elegooofficial/Neptune3/README.md

# Neptune3
Opensource files for ELEGOO Neptune 3 FDM 3D printer
