elegooofficial/Neptune3/Firmware/Mainboard/ZNP_F401_Marlin/config/README.md

# Where have all the configurations gone?

## https://github.com/MarlinFirmware/Configurations/archive/release-2.0.9.3.zip
