elegooofficial/Neptune3/BOM/Neptune 3_BOM.xlsx

Neptune 3_BOM
Order | Part Code | Part Name | Specification | Unit | Qty
1 | 01.001.0011 | 2020 Aluminum profile_X-axis profile | 20*20-L347mm | pcs | 1.00
2 | 01.001.0002 | 2020 Aluminum profile_Top | 20*20-L330mm | pcs | 1.00
3 | 01.002.0004 | 2040 Aluminum profile_Right | 20*40-L430mm | pcs | 1.00
4 | 01.002.0005 | 2040 Aluminum profile_Left | 20*40-L430mm | pcs | 1.00
5 | 01.003.0007 | 4040 Aluminum profile_Y-axis | 40*40-L347mm | pcs | 1.00
6 | 01.003.0005 | 4040 Aluminum profile_Bottom & Right | 40*40-L290mm | pcs | 1.00
7 | 01.003.0006 | 4040 Aluminum profile_Bottom & Left | 40*40-L290mm | pcs | 1.00
8 | 01.003.0004 | 4040 Aluminum profile_Bottom | 40*40-L250mm | pcs | 1.00
9 | 02.001.0016 | Fixing Plate_Extruder | 2.5mm Aluminum alloy plate，AL5052 | pcs | 1.00
10 | 02.002.0023 | Fixing Plate_X-axis Motor | SPCC t=2.5mm,Black powder spraying | pcs | 1.00
11 | 02.003.0001 | Bracket_Pressure Sensor | 65Mn t=2.0mm,Heat treatment hardness：45HRC,Zinc surface-plating | pcs | 1.00
12 | 02.002.0024 | Trigger_Photoelectric Switch | SPCC t=1.2mm,Black powder spraying | pcs | 1.00
13 | 02.002.0025 | Fixing Plate_Y-axis Motor | SPCC t=2.0mm,Black powder spraying | pcs | 1.00
14 | 02.002.0026 | Driven Plate_Z-axis | SPCC t=2.5mm,Black powder spraying | pcs | 1.00
15 | 02.002.0027 | Fixing Plate_Nozzle Kit | SPCC t=2.5mm,Black powder spraying | pcs | 1.00
16 | 02.002.0028 | Bottom Slider Plate | SPCC t=3.0mm,Black powder spraying | pcs | 1.00
17 | 07.006.0005 | Thermistor_Heated Bed | D1.8_L900mm_100K_With terminals | pcs | 1.00
18 | 07.006.0006 | Thermistor_Nozzle Kit | D1.8_L1500mm_100K_With terminals | pcs | 1.00
19 | 07.007.0003 | Heating Tube | 24V，40W-L1070mm，Φ6*20 | pcs | 1.00
20 | 07.005.0001 | 5015 Turbo Fan | 24V_5015_L120mm_Turbo Fan_4500 rpm_With terminals | pcs | 1.00
21 | 07.005.0007 | 4010 Turbo Fan | 24V_4010_L1420mm_Turbo Fan_6500 rpm_With terminals | pcs | 1.00
22 | 07.005.0008 | 4010 Axial Fan | 24V_4010_L1340mm_Axial Fan_5500 rpm_With terminals | pcs | 1.00
23 | 04.001.0001 | Yellew Earth Wire | 18AWG_L170mm_4.0 U-terminal+4.8 Plug spring terminal | pcs | 1.00
24 | 04.001.0002 | Black Silicone Wire | 16AWG_L170mm_4.0 U-terminal+4.8 Plug spring terminal | pcs | 1.00
25 | 04.002.0001 | Heated Bed Wire | 2*1.5mm2_L600mm_Strip 6mm at both ends and add tin | pcs | 1.00
26 | 04.001.0003 | Red Silicone Wire | 16AWG_L90mm_4.8 Plug spring terminal(Both sides) | pcs | 1.00
27 | 04.003.0001 | Red And Black Wire_Mainboard | 16AWG_L410mm_Amass XT60 female terminal+Strip 5mm and add tin | pcs | 1.00
28 | 04.004.0001 | Red And Black Wire_Power Supply | 16AWG-L200mm_Amass XT60 male terminal+4.0 U-terminal | pcs | 1.00
29 | 04.005.0011 | Motor and Limit Switch Wire_Y-axis | Motor-L530mm_Limit switch-L630mm | pcs | 1.00
30 | 04.005.0012 | Motor Wire_Z-axis | L400mm | pcs | 1.00
31 | 04.005.0013 | Photoelectric Switch Wire | L470mm | pcs | 1.00
32 | 04.001.0004 | Red Silicone Wire_Combined Switch | 16AWG_L170mm_4.0 U-terminal+4.8 Plug spring terminal | pcs | 1.00
33 | 04.005.0014 | Motor and Limit Switch Wire_X/E-axis | E-axis motor-L960mm_X-axis motor-L1010mm_X-axis limit switch-L1160mm | pcs | 1.00
34 | 04.005.0015 | Pressure Sensor Wire | L1020mm | pcs | 1.00
35 | 04.001.0011 | DC Socket Cable_Red | 18AWG_L160mm_4.0 U-terminal+Strip 5mm and add tin | pcs | 1.00
36 | 04.001.0012 | DC Socket Cable_Black | 18AWG_L195mm_4.0 U-terminal+Strip 5mm and add tin | pcs | 1.00
37 | 04.006.0002 | Filament Detector Wire | L1030mm | pcs | 1.00
38 | 05.001.0041 | Plastic Bottom Box | Black_ABS765A Fireproof materials_Fire ratingV-0 | pcs | 1.00
39 | 05.001.0042 | Plastic Bottom Cover | Black_ABS765A Fireproof materials_Fire ratingV-0 | pcs | 1.00
40 | 05.001.0043 | Power Supply Fixing Box | Black_ABS765A Fireproof materials_Fire ratingV-0 | pcs | 1.00
41 | 05.001.0044 | Fan Cover | Grey_ABS765A Fireproof materials_Fire ratingV-0 | pcs | 1.00
42 | 05.001.0045 | Air Guide Ring | Black_ABS765A Fireproof materials_Fire ratingV-0 | pcs | 1.00
43 | 05.001.0046 | Air Deflector Ⅰ | Black_ABS765A Fireproof materials_Fire ratingV-0 | pcs | 1.00
44 | 05.001.0047 | Air Deflector Ⅱ | Black_ABS765A Fireproof materials_Fire ratingV-0 | pcs | 1.00
45 | 05.001.0048 | Fixed Seat of Heated Bed Wire | Black_ABS765A Fireproof materials_Fire ratingV-0 | pcs | 1.00
46 | 05.001.0049 | Housing of Display Screen | Grey_ABS765A Fireproof materials_Fire ratingV-0 | pcs | 1.00
47 | 05.001.0050 | Cover of Display Screen | Grey_ABS765A Fireproof materials_Fire ratingV-0 | pcs | 1.00
48 | 05.001.0051 | Display Bracket | Grey_ABS765A Fireproof materials_Fire ratingV-0 | pcs | 1.00
49 | 05.001.0013 | Fixed Seat of Limit Switch_Y-axis | Black_ABS765A Fireproof materials_Fire ratingV-0 | pcs | 1.00
50 | 05.001.0052 | Tensioner Cover Ⅱ | Grey_ABS765A Fireproof materials_Fire ratingV-0 | pcs | 1.00
51 | 05.001.0053 | Mounting Seat of Sensor Adapter Plate | Black_ABS765A Fireproof materials_Fire ratingV-0 | pcs | 1.00
52 | 05.001.0054 | Mounting Seat of Guide Wheel | Black_ABS765A Fireproof materials_Fire ratingV-0 | pcs | 1.00
53 | 05.001.0055 | Housing of Filament Detector Switch | Black_ABS765A Fireproof materials_Fire ratingV-0 | pcs | 1.00
54 | 05.001.0056 | Cover of Filament Detector Switch | Black_ABS765A Fireproof materials_Fire ratingV-0 | pcs | 1.00
55 | 05.001.0057 | Compression Plate | Black_ABS765A Fireproof materials_Fire ratingV-0 | pcs | 1.00
56 | 05.001.0058 | Code Disc | Black_ABS765A Fireproof materials_Fire ratingV-0 | pcs | 1.00
57 | 05.001.0059 | Handle | Black_ABS765A Fireproof materials_Fire ratingV-0 | pcs | 1.00
58 | 05.001.0060 | Housing of Photoelectric Switch | Black_ABS765A Fireproof materials_Fire ratingV-0 | pcs | 1.00
59 | 05.001.0061 | Cover of Photoelectric Switch | Black_ABS765A Fireproof materials_Fire ratingV-0 | pcs | 1.00
60 | 05.001.0062 | Passive Slider | Grey_ABS765A Fireproof materials_Fire ratingV-0 | pcs | 2.00
61 | 05.001.0063 | Tensioner Cover | Grey_ABS765A Fireproof materials_Fire ratingV-0 | pcs | 1.00
62 | 05.001.0064 | Hand Screw Nut_D20 | Grey_ABS765A Fireproof materials_Fire ratingV-0 | pcs | 2.00
63 | 05.001.0065 | Fixed Seat of Limit Switch_X-axis | Grey_ABS765A Fireproof materials_Fire ratingV-0 | pcs | 1.00
64 | 05.001.0014 | Filament Holder | Black_ABS765A Fireproof materials_Fire ratingV-0 | pcs | 1.00
65 | 05.001.0015 | Filament Tube | Black_ABS765A+PC Fireproof materials_Fire ratingV-0 | pcs | 1.00
66 | 05.001.0016 | 4040 Profile Cover | Black_ABS765A Fireproof materials_Fire ratingV-0 | pcs | 4.00
67 | 05.001.0017 | 2020 Profile Cover | Black_ABS765A Fireproof materials_Fire ratingV-0 | pcs | 2.00
68 | 05.001.0019 | Fixed Seat of Stepper_Z-axis | Black_ABS765A Fireproof materials_Fire ratingV-0 | pcs | 1.00
69 | 05.001.0021 | Pneumatic Fittings Circlip | φ5.7mm_Blue | pcs | 3.00
70 | 05.001.0020 | Silicone Cover | Silica Gel_Black | pcs | 1.00
71 | 08.001.0013 | Mainboard_F401 | ZNP Robin Nano_DW V2.0 | pcs | 1.00
72 | 08.002.0004 | Display Screen | 4.3 inch serial port screen_DWIN | pcs | 1.00
73 | 04.011.0007 | Telephone Handset Cable | Black spring wire_RJ11 crystal head_4P4C telephone wire_2m | pcs | 1.00
74 | 04.011.0008 | Crystal Head Socket | RJ11_4P4C crystal head socket | pcs | 1.00
75 | 07.003.0001 | Limit Switch | With PCBA | pcs | 2.00
76 | 07.003.0013 | Photoelectric Switch Ⅰ | With PCBA | pcs | 1.00
77 | 08.001.0014 | Control Board of Pressure Sensor | Glevel V1.0 | pcs | 1.00
78 | 07.003.0014 | Pressure Sensor | L510mm_XH2.54-4Y | pcs | 1.00
79 | 07.003.0015 | DC Socket | DC022BC，φ2.5mm | pcs | 1.00
80 | 07.003.0016 | Photoelectric Switch Ⅱ | With PCBA | pcs | 1.00
81 | 07.002.0004 | 42-34 Stepper_Black（Flat shaft） | 42HD2037-02，Two-phase，Black | pcs | 2.00
82 | 07.002.0005 | 42-34 Stepper_Black（Circular Axis） | 42HD2037-04，Two-phase，Black | pcs | 1.00
83 | 07.002.0006 | 42-40 Stepper_Black | 42HD4027-02，Two-phase，Black | pcs | 1.00
84 | 07.001.0001 | Power Supply_Black | 24V_15A | pcs | 1.00
85 | 07.003.0003 | Combination Switch | Three-in-one combination switch | pcs | 1.00
86 | 08.003.0001 | Fuse | 10A_250V_5mm*20mm | pcs | 1.00
87 | 07.004.0002 | Heated Bed Platform | 24V_250W_235mm*235mm | pcs | 1.00
88 | 03.002.0001 | Heating Block | 20mm*20mm*10mm | pcs | 1.00
89 | 03.003.0004 | Heat Dissipation Block | AL6061_12mm*33.8mm | pcs | 1.00
90 | 03.004.0001 | Nozzle | 0.4mm | pcs | 3.00
91 | 03.005.0003 | Throat Tube_Titanium Alloy | Titanium Alloy_D7mm_M6_L27mm_through | pcs | 1.00
92 | 03.007.0001 | V-slot Wheel | Black_Imported POM_Size：24*10mm | pcs | 13.00
93 | 03.006.0001 | Metal Eccentric Spacer | D7.2mm_d5mm_H8.35mm_Outer Hexagon | pcs | 5.00
94 | 03.006.0002 | Metal Spacer | D7.2mm_d5mm_H8.35mm_Outer Hexagon | pcs | 11.00
95 | 03.007.0004 | Extruder Base | AL6061_Red anodizing | pcs | 1.00
96 | 03.007.0005 | Extruder Handle | AL6061_Red anodizing | pcs | 1.00
97 | 03.007.0003 | T-shaped Shaft Sleeve | AL6061_Red anodizing | pcs | 1.00
98 | 03.001.0002 | Extrusion Gear Ⅰ | SUS303_13.8mm*9.3mm | pcs | 1.00
99 | 03.001.0003 | Extrusion Gear Ⅱ | SUS303_13.8mm*9.3mm | pcs | 1.00
100 | 03.007.0021 | Fixed Base of Pneumatic Fittings | AL6061_Red anodizing | pcs | 1.00
101 | 06.004.0007 | Compression Spring | φ8mm*φ0.9mm*10mm | pcs | 1.00
102 | 06.004.0008 | Yellow Die Spring | D10*L18mm_Yellow | pcs | 1.00
103 | 06.001.0004 | Needle Bearing | φ3mm*φ5mm*7mm | pcs | 2.00
104 | 06.001.0002 | Ball bearing_F-624-ZZ | F-624-ZZ | pcs | 4.00
105 | 06.001.0003 | Ball bearing_625-ZZ | 625-ZZ | pcs | 26.00
106 | 06.001.0001 | Ball bearing_U-624 | U-624 | pcs | 2.00
107 | 06.001.0007 | Ball bearing_V-624 | V-624 | pcs | 2.00
108 | 06.001.0008 | Ball bearing_MR-84-ZZ | MR-84-ZZ | pcs | 1.00
109 | 06.002.0003 | Cylindrical Pin Ⅰ | D4mm_L10mm | pcs | 1.00
110 | 06.002.0004 | Cylindrical Pin Ⅱ | D4mm_L14mm | pcs | 1.00
111 | 06.003.0006 | Lead Screws_T8-8 | T8mm*8mm_L380mm | pcs | 1.00
112 | 06.003.0002 | Lead Screws Nut_T8-8 | T8mm*8mm | pcs | 1.00
113 | 06.007.0001 | Rigid Coupling | d5mm_D8mm | pcs | 1.00
114 | 06.009.0001 | Pneumatic Fittings | PC4-1/8PT | pcs | 3.00
115 | 06.006.0001 | Timing Pulley | 2GT_d5mm_20teeth-W6mm | pcs | 2.00
116 | 05.002.0001 | Timing Belt | 2GT-W6 | roll | 0.01542
117 | 06.009.0002 | Copper Sleeve_Timing Belt | D7mm_0.5mm | pcs | 4.00
118 | 05.003.0001 | Nylon Column | D7mm_d4.2mm_H15mm | pcs | 11.00
119 | 10.008.0003 | PEI Platform | 235mm*245mm | pcs | 1.00
120 | 10.008.0011 | Soft Magnetic Plate | 235mm*235mm*1mm | pcs | 1.00
121 | 10.005.0003 | Rubber Mat | 20mm*40mm*6mm | pcs | 4.00
122 | 11.008.0002 | EVA Pad | D6mm_H1mm | pcs | 0.04
123 | 09.004.0008 | Silicone Crash Pad Ⅱ | Transparent silica gel_D8mm_H2mm | pcs | 2.00
124 | 09.004.0007 | Silicone Crash Pad Ⅰ | Transparent silica gel_D8mm_H3mm | pcs | 4.00
125 | 05.007.0005 | Teflon Tube_Blue | D4mm-d2mm_Blue | m | 0.12
126 | 05.007.0001 | Teflon Tube | D4mm-d2mm_white | m | 0.34
127 | 10.001.0001 | Braided Tube | W8mm_L410mm | pcs | 2.00
128 | 10.001.0003 | Braided Tube | W12mm_L670mm | pcs | 1.00
129 | 11.003.0001 | Insulation Cotton | 50mm*60mm | pcs | 0.005
130 | 10.007.0006 | Cable Tie 2-150 | 2mm*150mm | pcs | 2.00
131 | 10.007.0004 | Cable Tie 4-150 | 4mm*150mm | pcs | 15.00
132 | 10.007.0002 | Fixed Head Cable Tie 3-100 | 3mm*100mm | pcs | 7.00
133 | 11.002.0003 | High Temperature Insulating Polyimide Tape Ⅰ | W10mm | roll | 0.0015
134 | 11.002.0002 | High Temperature Insulating Polyimide Tape Ⅱ | W50mm | roll | 0.0042
135 | 11.001.0001 | High Temp Resistant Thread Sealant | 272_Red_High Temp Resistant | g | 0.50
136 | 11.004.0001 | Grease | Transparent_Paste | g | 2.00
137 | 11.004.0002 | Thermal Grease | Grey | g | 0.20
138 | 11.006.0001 | Tin Wire | Unleaded_φ2mm_500g/roll | roll | 0.0010
139 | 11.002.0005 | Acetate Tape | Insulation_high temperature resistant_black,W40mm_30m/roll | roll | 0.0067
140 | 11.002.0004 | Adhesive Tape | W50mm_100m/roll | roll | 0.05
141 | 11.001.0002 | Instant Drying Adhesive | NO.480_Instant Drying Adhesive | g | 0.50
142 | 11.009.0001 | Heat Shrinkable Tube | φ2.5mm*20mm | pcs | 2.00
143 | 11.007.0001 | Hot Melt Glue Adhesive Stick | Transparent | pcs | 0.05
144 | 10.004.0001 | Tf Memory Card | 8G | pcs | 1.00
145 | 10.004.0002 | TF Memory Card Reader | CHUANYU | pcs | 1.00
146 | 07.001.0002 | Power Supply | Length:1.5M_Wire diameter:6.5mm_Rated power:2500W_Rated voltage:250V_Pure copper_3*0.75mm²_Plug:nickel-plated brass_Flame-Retardant PVC | pcs | 1.00
147 | 04.009.0001 | USB Cable | Bluish transparent_Type-A to Type-B_Length:53cm_Wire diameter:4.8mm | pcs | 1.00
148 | 10.008.0012 | Needle | Stainless Steel_L75mm_d0.35mm | pcs | 1.00
149 | 10.002.0001 | Metal Scraper | Stainless Steel_1.5#_Nickel-plated | pcs | 1.00
150 | 10.002.0002 | Nippers | Cutting Nippers | pcs | 1.00
151 | 10.002.0003 | 1.5mm Inner Hexagon Spanner | Carbon Steel_1.5mm_Nickel-plated | pcs | 1.00
152 | 10.002.0004 | 2.0mm Inner Hexagon Spanner | Carbon Steel_2.0mm_Nickel-plated | pcs | 1.00
153 | 10.002.0005 | 2.5mm Inner Hexagon Spanner | Carbon Steel_2.5mm_Nickel-plated | pcs | 1.00
154 | 10.002.0006 | 3.0mm Inner Hexagon Spanner | Carbon Steel_3.0mm_Nickel-plated | pcs | 1.00
155 | 10.002.0007 | 4.0mm Inner Hexagon Spanner | Carbon Steel_4.0mm_Nickel-plated | pcs | 1.00
156 | 10.002.0008 | Flat Blade Screwdriver | 2.5mm_Flat Blade | pcs | 1.00
157 | 10.002.0009 | Cruciform Screwdriver | 4.0mm_ Cruciform | pcs | 1.00
158 | 10.002.0010 | Double Open Spanner | 45#steel_8-10#_Galvanized | pcs | 1.00
159 | 10.002.0011 | Open Spanner | 45#steel_6#_Galvanized | pcs | 1.00
160 | 12.002.0001 | Self Sealing Bag Ⅰ | 18cm*26cm_Thickness:0.06mm | pcs | 1.00
161 | 12.002.0008 | Self Sealing Bag Ⅱ | 15cm*22cm_Thickness:0.08mm | pcs | 1.00
162 | 12.002.0003 | Self Sealing Bag Ⅲ | 9cm*13cm_Thickness:0.08mm | pcs | 2.00
163 | 12.002.0004 | Self Sealing Bag Ⅳ | 6cm*9cm_Thickness:0.08mm | pcs | 4.00
164 | 13.001.0001 | Filament | L5m_Random color | roll | 1.00
165 | 10.003.0001 | Product Certificate | Triangle | pcs | 1.00
166 | 12.003.0013 | Foam | 590mm*480mm*210mm | pcs | 1.00
167 | 12.001.0011 | Carton | 600mm*490mm*225mm | pcs | 1.00
168 | 10.003.0016 | User Guide | 210mm*120mm | pcs | 1.00
169 | 12.004.0012 | Manufacturing Number Sticker | 50mm*25mm | pcs | 1.00
170 | 12.004.0013 | Machine Specification Sticker | 70mm*38mm | pcs | 1.00
171 | 10.007.0003 | Plastic Twist Tie | White_Plastic Twist Tie_0.55mm*80mm | package | 0.001
172 | 10.003.0017 | Instructions | Four-color printing | pcs | 1.00
173 | 12.005.0013 | Warning Sticker | 65mm*35mm | pcs | 1.00
174 | 09.001.0002 | Hexagon Socket Countersunk Head Screw_M3*10 | Stainless Steel_M3*10 | pcs | 1.00
175 | 09.001.0001 | Hexagon Socket Countersunk Head Screw_M3*18 | Stainless Steel_M3*18 | pcs | 4.00
176 | 09.001.0009 | Hexagon Socket Countersunk Head Screw_M3*28 | Stainless Steel_M3*28 | pcs | 2.00
177 | 09.001.0003 | Hexagon Socket Countersunk Head Screw_M4*20 | Carbon Steel_M4*20 | pcs | 2.00
178 | 09.001.0010 | Cross Recessed Countersunk Head Screw_M4*22 | Stainless Steel_M4*22 | pcs | 11.00
179 | 09.002.0003 | Hexagon Socket Button Head Screw_M5*30 | Stainless Steel_M5*30 | pcs | 10.00
180 | 09.002.0001 | Hexagon Socket Button Head Screw_M3*6 | Stainless Steel_M3*6 | pcs | 14.00
181 | 09.002.0006 | Hexagon Socket Button Head Screw_M5*8 | Stainless Steel_M5*8 | pcs | 6.00
182 | 09.002.0007 | Hexagon Socket Button Head Screw_M4*16 | Stainless Steel_M4*16 | pcs | 7.00
183 | 09.002.0012 | Hexagon Socket Button Head Screw_M3*8 | Stainless Steel_M3*8 | pcs | 1.00
184 | 09.002.0011 | Hexagon Socket Button Head Screw_M4*12 | Stainless Steel_M4*12 | pcs | 1.00
185 | 09.002.0004 | Hexagon Socket Button Head Screw_M3*10 | Stainless Steel_M3*10 | pcs | 9.00
186 | 09.002.0005 | Hexagon Socket Button Head Screw_M5*40 | Stainless Steel_M5*40 | pcs | 3.00
187 | 09.002.0009 | Hexagon Socket Button Head Screw_M3*12 | Stainless Steel_M3*12 | pcs | 2.00
188 | 09.002.0002 | Hexagon Socket Button Head Screw_M3*16 | Stainless Steel_M3*16 | pcs | 2.00
189 | 09.003.0007 | Hexagon Socket Head Cap Screw_M4*10 | Stainless Steel_M4*10 | pcs | 4.00
190 | 09.003.0002 | Hexagon Socket Head Cap Screw_M3*18 | Stainless Steel_M3*18 | pcs | 4.00
191 | 09.003.0004 | Hexagon Socket Head Cap Screw_M4*20 | Stainless Steel_M4*20 | pcs | 2.00
192 | 09.003.0012 | Hexagon Socket Head Cap Screw_M3*5 | Stainless Steel_M3*5 | pcs | 3.00
193 | 09.003.0001 | Hexagon Socket Head Cap Screw_M4*8 | Stainless Steel_M4*8 | pcs | 7.00
194 | 09.003.0008 | Hexagon Socket Head Cap Screw_M3*20 | Stainless Steel_M3*20 | pcs | 1.00
195 | 09.003.0009 | Hexagon Socket Head Cap Screw_M3*25 | Stainless Steel_M3*25 | pcs | 1.00
196 | 09.004.0003 | M5 Flat Washer | Stainless Steel_M5 | pcs | 5.00
197 | 09.004.0001 | M5 Flat Washer_V-slot Wheel | Stainless Steel_M5_φ5mm*φ8mm*1mm | pcs | 13.00
198 | 09.004.0005 | M3 Flat Washer | Stainless Steel_M3_φ3.2mm*φ6.5mm*0.5mm | pcs | 1.00
199 | 09.004.0006 | M3 Silicone Flat Rubber Washer | Silicone_M3_φ3mm*φ7mm*1mm | pcs | 4.00
200 | 09.004.0002 | M3 Spring Washer | Stainless Steel_M3 | pcs | 2.00
201 | 09.005.0002 | M5 Self-locking Nut | Stainless Steel_M5 | pcs | 13.00
202 | 09.005.0001 | M4 T-nut | Stainless Steel_M4 | pcs | 7.00
203 | 09.005.0006 | M3 Blind Rivet Nuts | Carbon Steel_M3 | pcs | 1.00
204 | 09.005.0005 | M4 Square Slide Nut | 2020 Aluminum profile_M4 Square Slide Nut | pcs | 2.00
205 | 09.006.0006 | Large Flat Head Tapping Screw_Point Tail_3*25 | Stainless Steel_TA 3*25 | pcs | 2.00
206 | 09.006.0003 | Pan Head Tapping Screws_Point Tail_3*8 | Carbon Steel_PA 3*8 | pcs | 8.00
207 | 09.006.0002 | Pan Head Tapping Screws_Point Tail_3*12 | Stainless Steel_PA 3*12 | pcs | 9.00
208 | 09.006.0005 | Pan Head Tapping Screws_Scrape Tail_3*6 | Stainless Steel_PT 3*6 | pcs | 6.00
209 | 09.006.0007 | Pan Head Tapping Screws_Point Tail_3*16 | Stainless Steel_PA 3*16 | pcs | 2.00
210 | 09.006.0008 | Pan Head Tapping Screws_Point Tail_2*8 | Stainless Steel_PA 2*8 | pcs | 4.00
211 | 09.006.0009 | Pan Head Tapping Screws_Point Tail_2*10 | Stainless Steel_KA 2*10 | pcs | 2.00
212 | 09.007.0004 | Combination Screw with Spring washer_M5*45 | Carbon Steel_M5*45 | pcs | 14.00
213 | 09.007.0002 | Combination Screw with Spring washer_M4*18 | Carbon Steel_M4*18 | pcs | 4.00
214 | 09.007.0001 | Combination Screw_M3*4 | Stainless Steel_M3*4 | pcs | 1.00
215 | 09.007.0003 | Combination Screw with Spring washer_M5*25 | Carbon Steel_M5*25 | pcs | 4.00
216 | 09.008.0008 | Album screw_M4*16_Female Nail | Stainless Steel_L16mm | pcs | 2.00
217 | 09.008.0001 | Set Screw_M3*3 | Carbon Steel_M3*3 | pcs | 2.00
218 | 09.008.0009 | Album screw_M4*10_Female Nail | Stainless Steel_L10mm | pcs | 2.00
219 | 09.008.0010 | Album screw_M4_Male Nail | Stainless Steel_M3*10 | pcs | 4.00
220 | 09.008.0007 | Album screw_M4*5_Female Nail | Stainless Steel_L5mm | pcs | 2.00
