elegooofficial/Neptune3/(list of files, cad)

Other CAD files:
Wire/Red And Black Wire_Mainboard.dwg
2D/Mounting Seat of Sensor Adapter Plate-A.DWG
Wire/Thermistor_Nozzle Kit.dwg
2D/Throat Tube.DWG
Wire/5015 Turbo Fan.dwg
2D/Tensioner Cover Ⅱ-A.DWG
Wire/Thermistor_Heated Bed.dwg
2D/T-shaped Shaft Sleeve-C.DWG
Wire/4010 Axial Fan.dwg
2D/Trigger_Photoelectric Switch-A.DWG
2D/Power Supply Fixing Box-B.DWG
Wire/Motor Wire_Z-axis.dwg
2D/Plastic Bottom Box-A.DWG
Wire/Motor and Limit Switch Wire_XE-axis.dwg
2D/Nozzle.DWG
Wire/4010 Turbo Fan.dwg
2D/Silicone Cover.DWG
Wire/Yellew Earth Wire.dwg
2D/Passive Slider.DWG
Wire/Photoelectric Switch Wire.dwg
2D/Tensioner Cover.DWG
Wire/Red And Black Wire_Power Supply.dwg
2D/V-slot Wheel.DWG
Wire/Red Silicone Wire.dwg
2D/Plastic Bottom Cover-A.DWG
Wire/Pressure Sensor Wire.dwg
2D/4040 Aluminum profile_Bottom.DWG
Wire/DC Socket Cable_Red.dwg
2D/2040 Aluminum profile_Right-A.DWG
Wire/Motor and Limit Switch Wire_Y-axis.dwg
2D/Fixing Plate_Extruder-B.DWG
Wire/Red Silicone Wire_Combined Switch.dwg
2D/2020 Aluminum profile_Top.DWG
Wire/Heating Tube.dwg
2D/Metal Eccentric Spacer.DWG
Wire/Heated Bed Wire.dwg
2D/Air Deflector Ⅰ-A.DWG
Wire/Black Silicone Wire.dwg
2D/Cover of Photoelectric Switch-A.DWG
Wire/Filament Detector Wire.dwg
2D/Heat Dissipation Block-B.DWG
Wire/DC Socket Cable_Black.dwg
2D/Code Disc-A.DWG
2D/Extruder BaseA.DWG
2D/Compression Plate-A.DWG
2D/Extrusion Gear 1.DWG
2D/Air Deflector Ⅱ-A.DWG
2D/Handle-A.DWG
2D/Heating Block.DWG
2D/Housing of Filament Detector Switch-A.DWG
2D/Driven Plate_Z-axis-A.DWG
2D/Fixed Seat of Limit Switch_X-axis.DWG
2D/Fixing Plate_Y-axis Motor-B.DWG
2D/2020 Profile Cover.DWG
2D/Fixed Seat of Limit Switch_Y-axis.DWG
2D/4040 Profile Cover.DWG
2D/Fan Cover-A.DWG
2D/2020 Aluminum profile_X-axis-A.DWG
2D/Fixed Seat of Stepper_Z-axis.DWG
2D/Cover of Display Screen-A.DWG
2D/Fixed Base of Pneumatic Fittings-B.DWG
2D/2040 Aluminum profile_Left-A.DWG
2D/Fixed Seat of Heated Bed Wire-A.DWG
2D/4040 Aluminum profile_Bottom & Right-B.DWG
2D/Filament Tube.DWG
2D/Bracket_Pressure Sensor-A.DWG
2D/Fixing Plate_Nozzle Kit-A.DWG
2D/Housing of Photoelectric Switch-A.DWG
2D/Cover of Filament Detector Switch-A.DWG
2D/Fixing Plate_X-axis Motor-B.DWG
2D/Display Bracket-A.DWG
2D/Extruder Handle-A.DWG
2D/Extrusion Gear 2.DWG
2D/Bottom Slider Plate-A.DWG
2D/4040 Aluminum profile_Bottom & Left-B.DWG
2D/Air Guide Ring-A.DWG
2D/Filament Holder.DWG
2D/Mounting Seat of Guide Wheel-A.DWG
2D/Housing of Display Screen-A.DWG
2D/Hand Screw Nut_D20.DWG
2D/Lead Screws Nut_T8.DWG
2D/Lead Screws_T8-8.DWG
