elegooofficial/Neptune3/2D/Mounting Seat of Guide Wheel-A.PDF

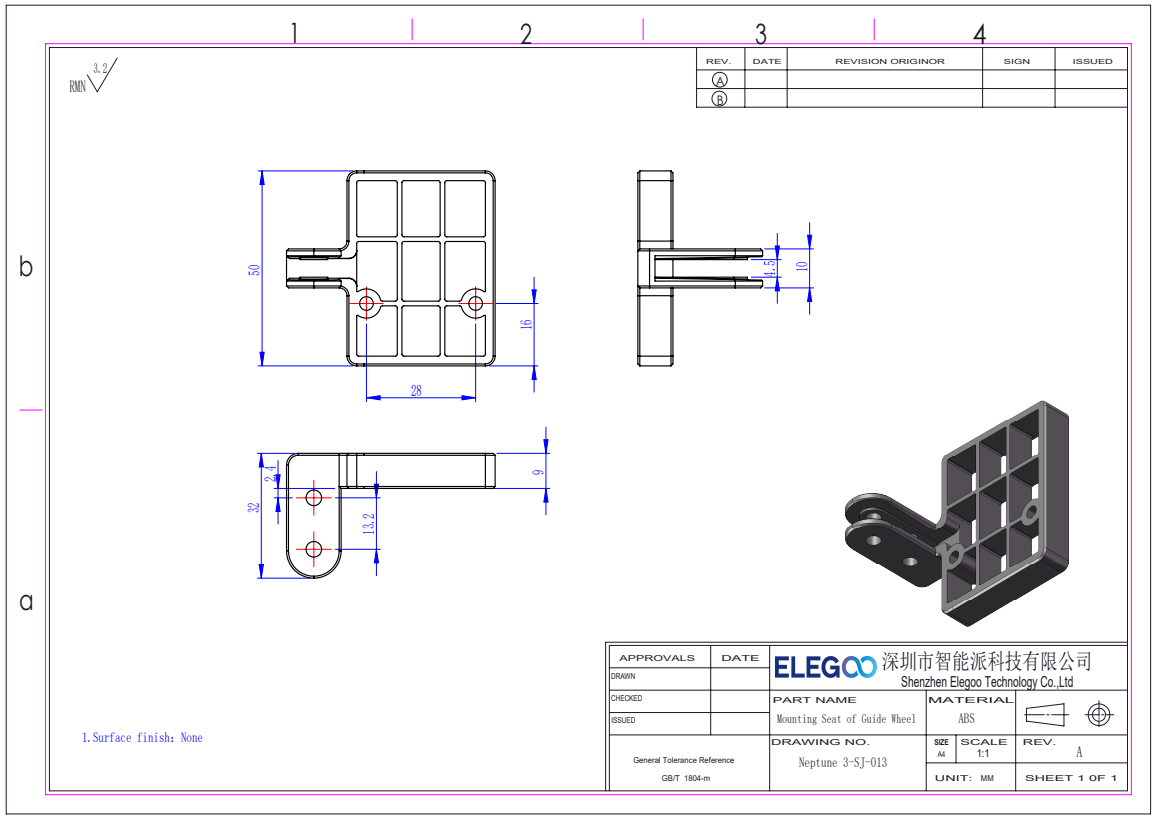
[picture p1: page 1]
Mounting Seat of Guide Wheel; ABS; Neptune 3-SJ-013; SIZE SCALE; UNIT: MM; DRAWING NO.; REV.; DATE; REVISION ORIGINOR; SIGN; ISSUED; PART NAME; SHEET 1 0F 1

深圳市智能派科技有限公司
Shenzhen Elegoo Technology Co.,Ltd

1.Surface finish：None

General Tolerance Reference
