elegooofficial/Neptune3/Wire/4010 Axial Fan.pdf

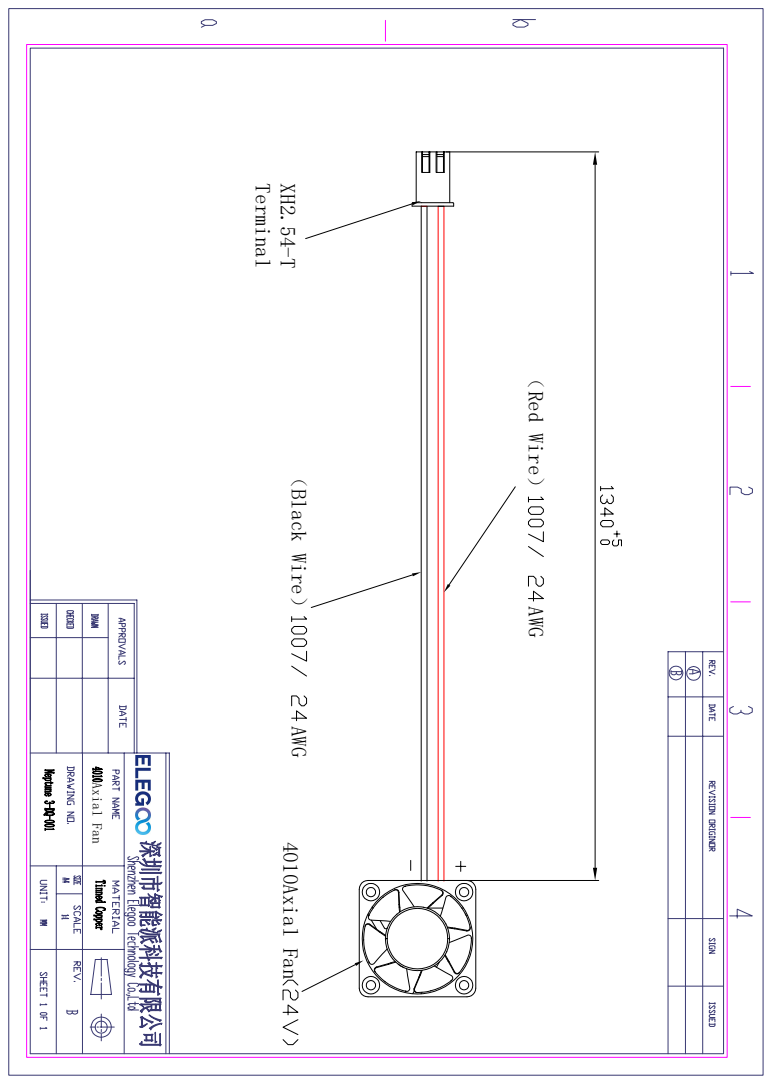
[picture p2: page 1]
Axial Fan; 4010Axial Fan; Terminal

（Red Wire） AWG

（Black Wire） AWG
