elegooofficial/Neptune3/Wire/4010 Turbo Fan.pdf

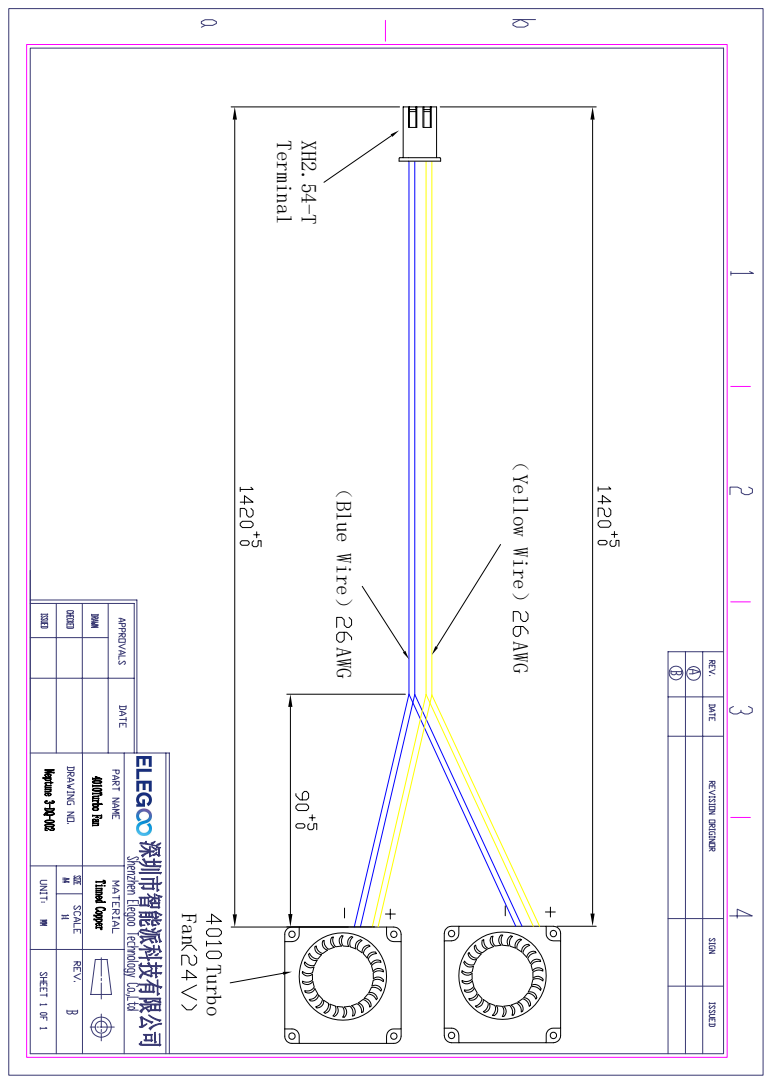
[picture p3: page 1]
Terminal; Turbo; Fan

（Yellow Wire） AWG

（Blue Wire） AWG
