elegooofficial/Neptune3/Wire/5015 Turbo Fan.pdf

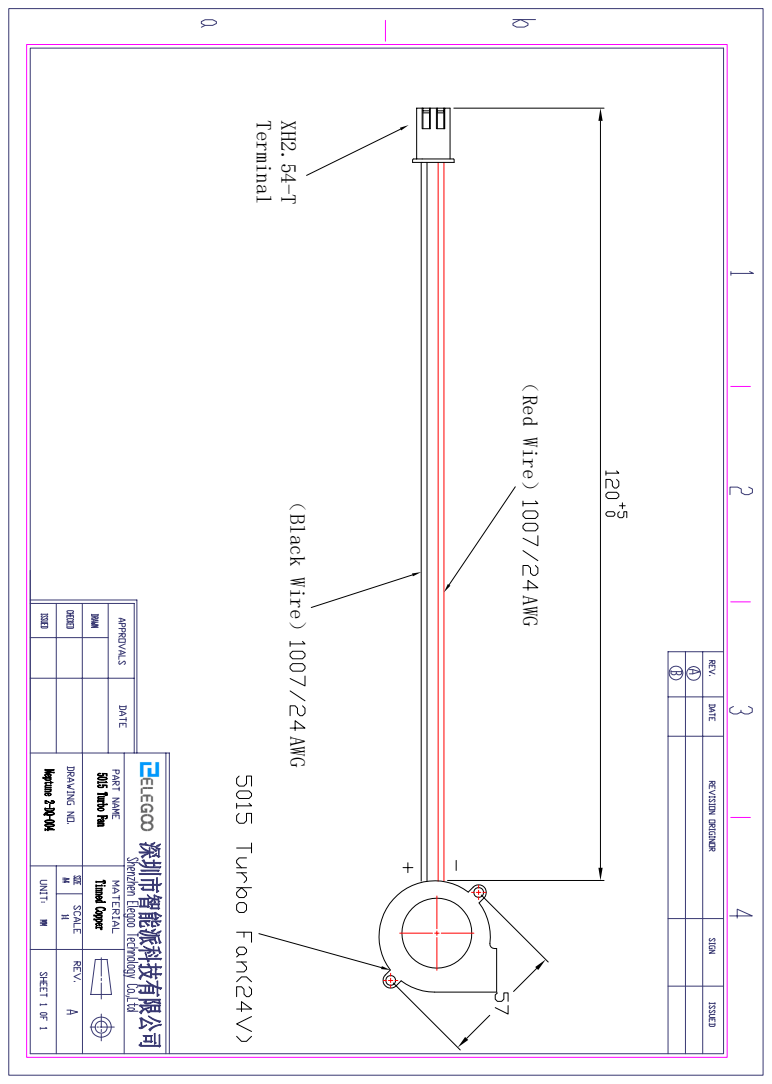
[picture p4: page 1]
Terminal

（Red Wire） AWG

（Black Wire） AWG
