elegooofficial/Neptune3/Wire/DC Socket Cable_Black.pdf

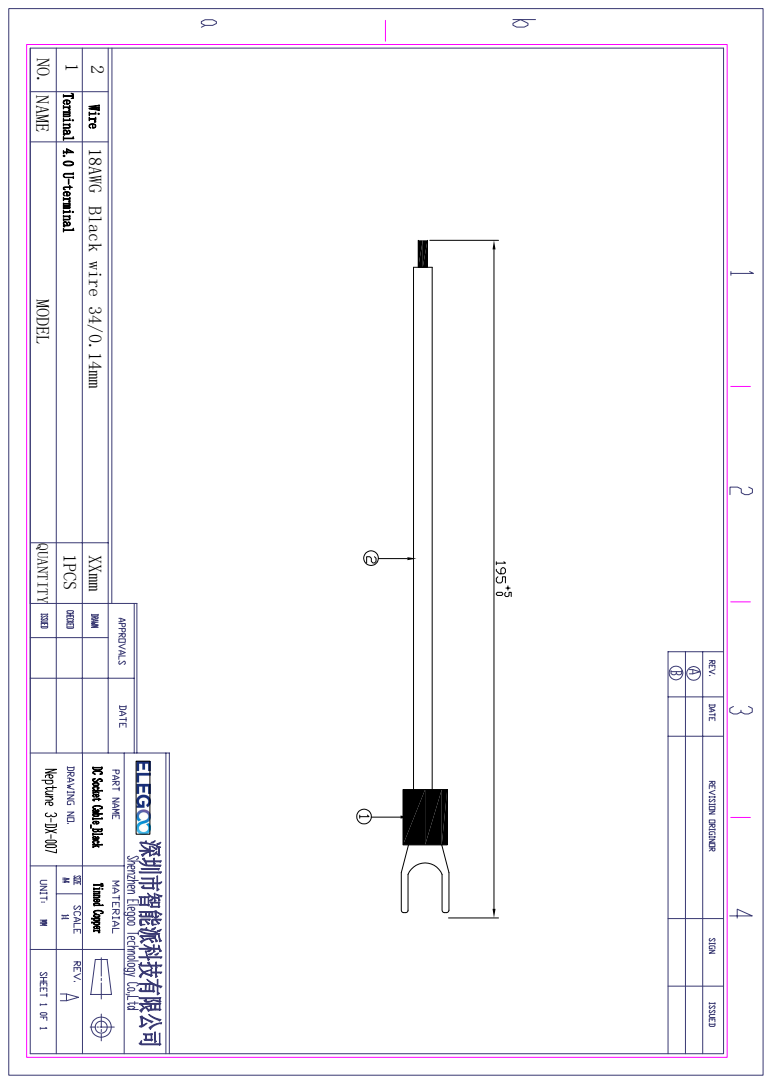
[picture p5: page 1]
1PCS

QUANTITY NO. NAME MODEL

2 18AWG Black wire 34/0.14mm XXmm
