elegooofficial/Neptune3/Wire/DC Socket Cable_Red.pdf

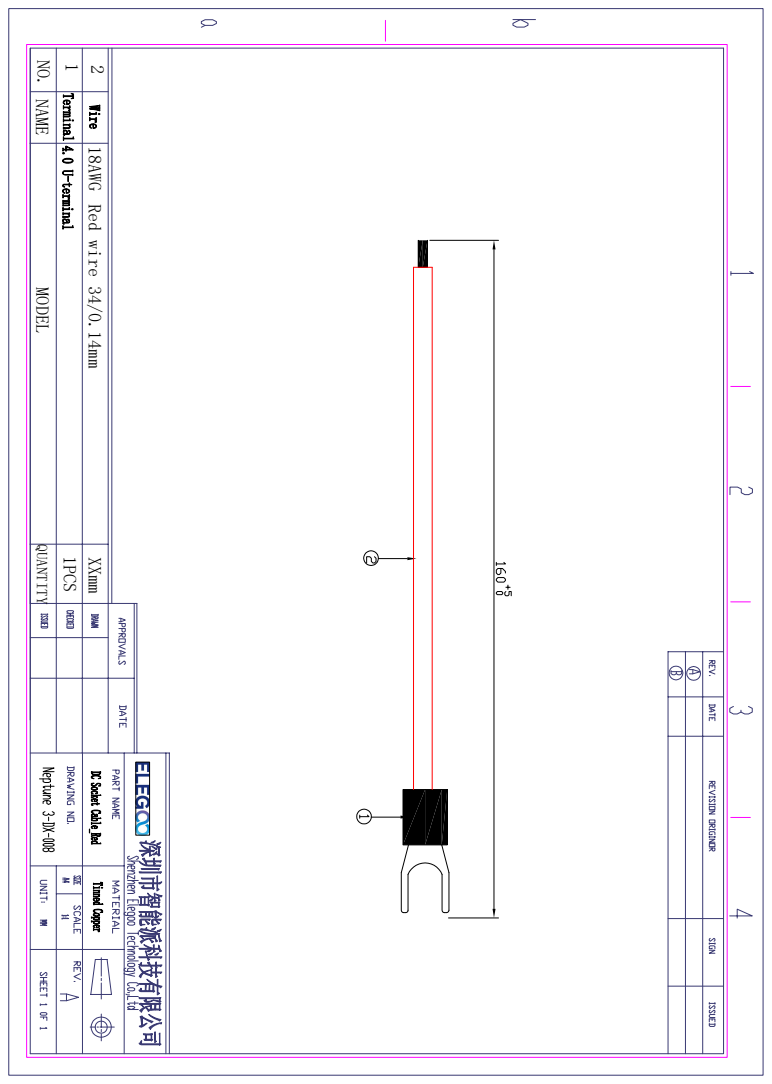
[picture p6: page 1]
1PCS

QUANTITY NO. NAME MODEL

XXmm 18AWG Red wire 34/0.14mm
