elegooofficial/Neptune3/Wire/Heated Bed Wire.pdf

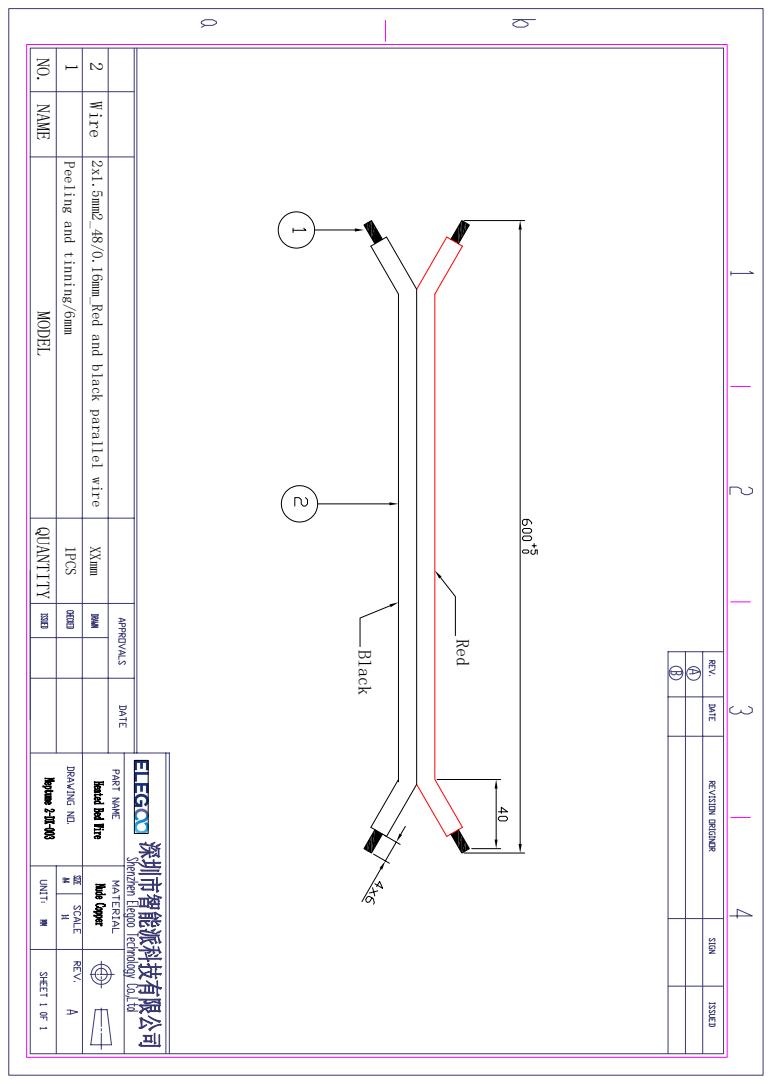
[picture p7: page 1]
NAME; Wire; MODEL; 1PCS; XXmm; QUANTITY; Red; Black

Peeling and tinning/6mm

2x1.5mm2_48/0.16mm_Red and black parallel wire
