elegooofficial/Neptune3/Wire/Heating Tube.pdf

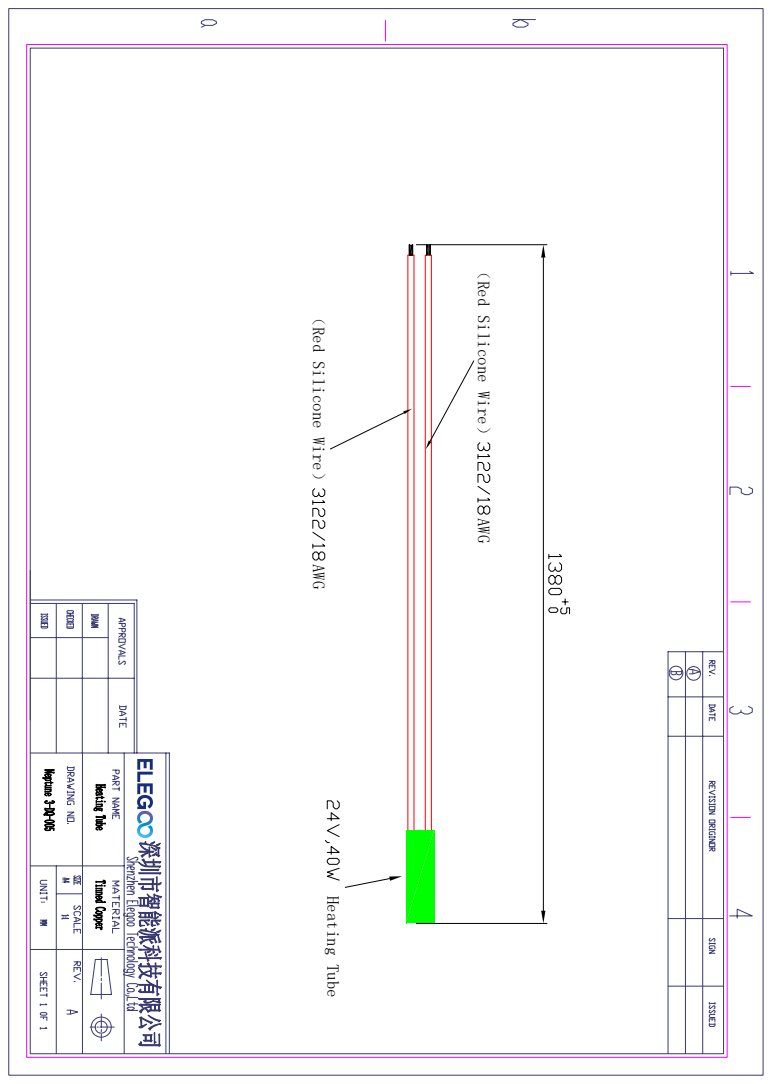
[picture p8: page 1]

（Red Silicone Wire） AWG

（Red Silicone Wire） AWG Heating Tube
