elegooofficial/Neptune3/Wire/Thermistor_Heated Bed.pdf

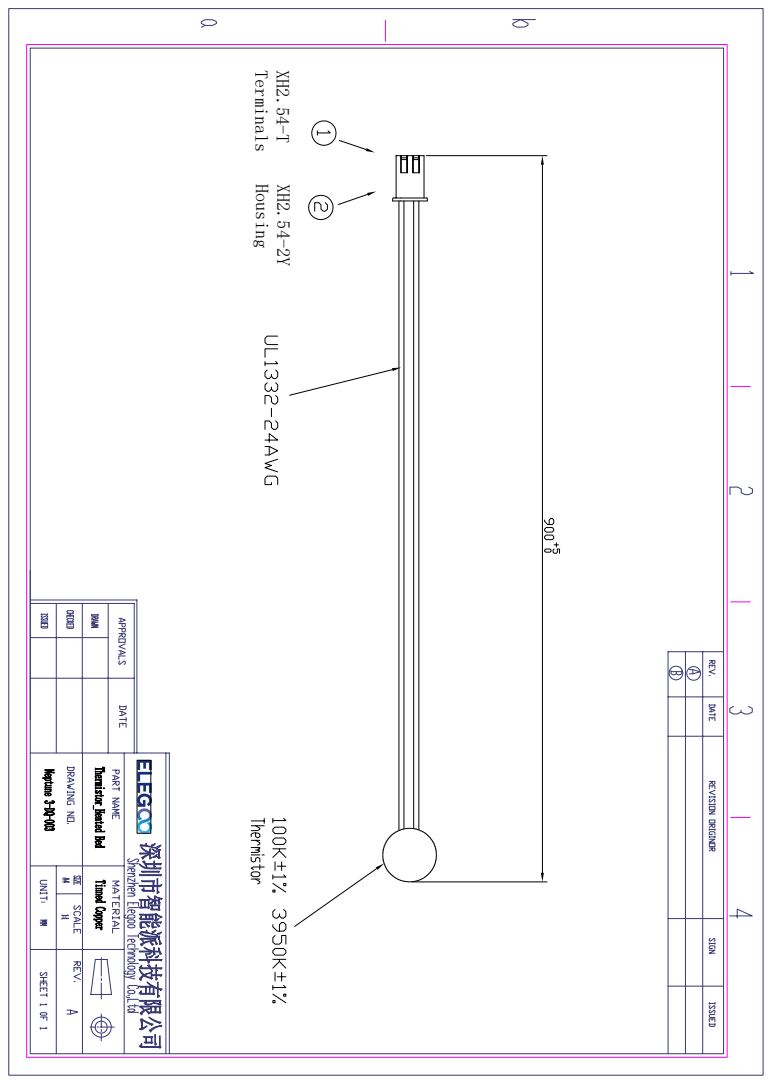
[picture p9: page 1]
Terminals; Housing
