elegooofficial/Neptune3/Wire/Thermistor_Nozzle Kit.pdf

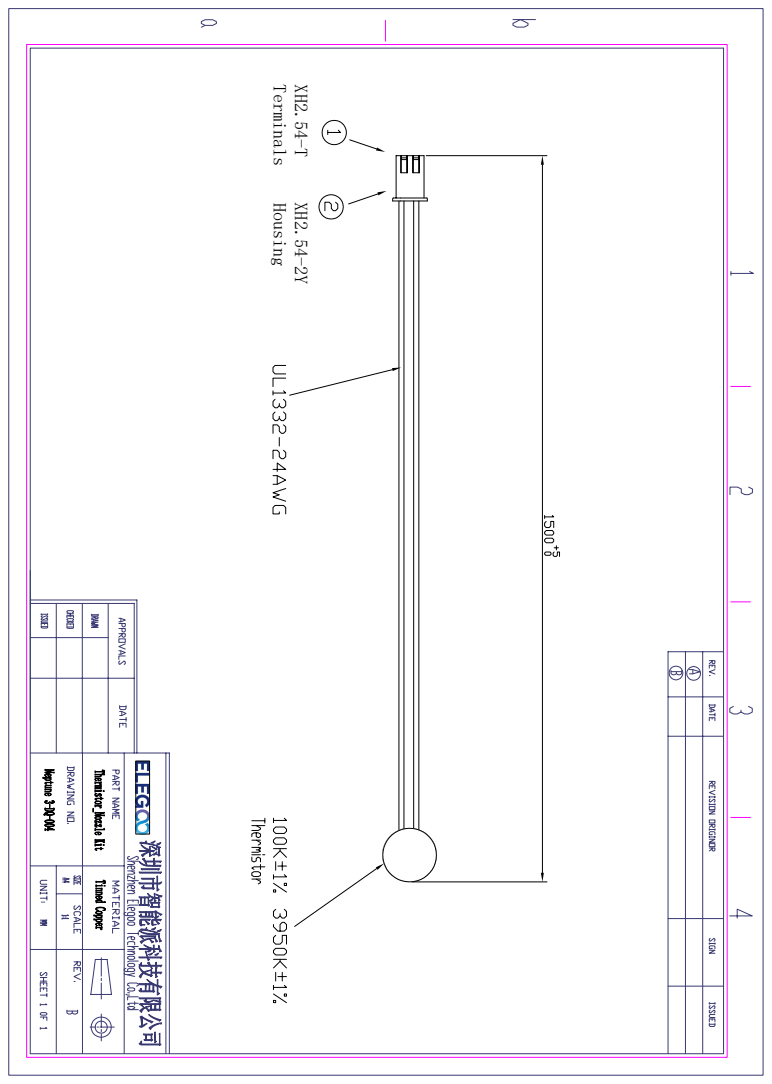
[picture p10: page 1]
Terminals; Housing
