elegooofficial/Neptune3/Wire/Yellew Earth Wire.pdf

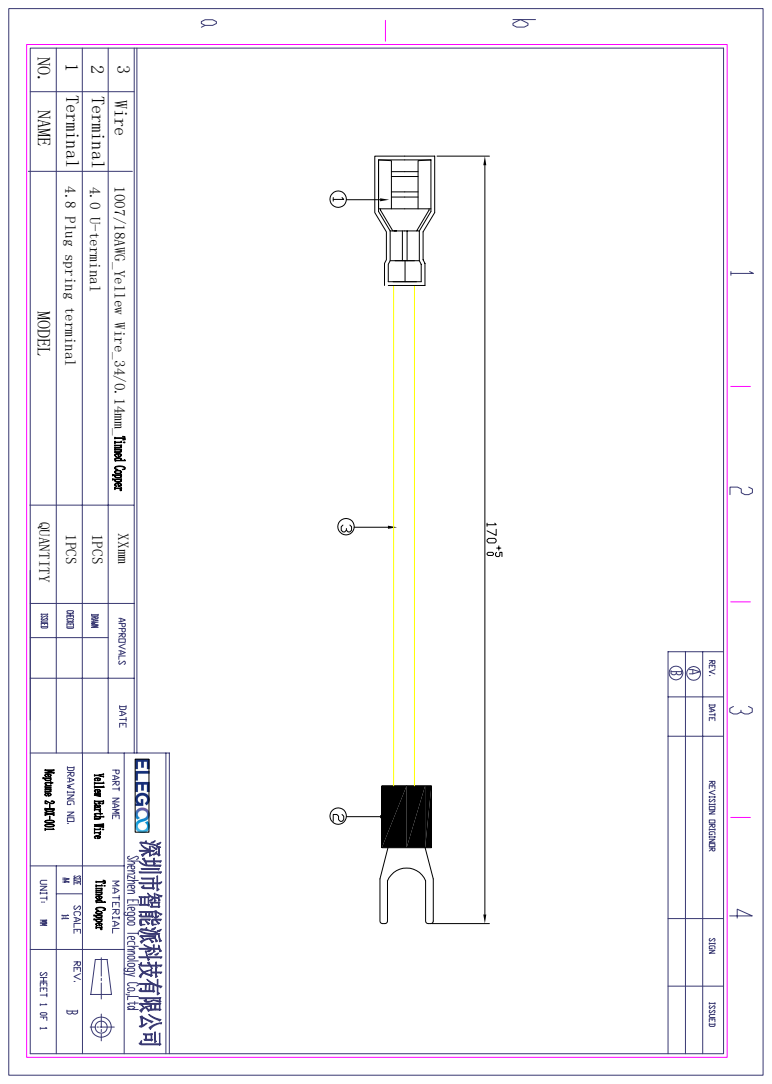
[picture p11: page 1]
Terminal; Wire; NAME; 4.0 U-terminal; 1007/18AWG_Yellew Wire_34/0.14mm_; MODEL; 1PCS; XXmm; QUANTITY

4.8 Plug spring terminal
