elegooofficial/Neptune3/2D/Mounting Seat of Sensor Adapter Plate-A.PDF

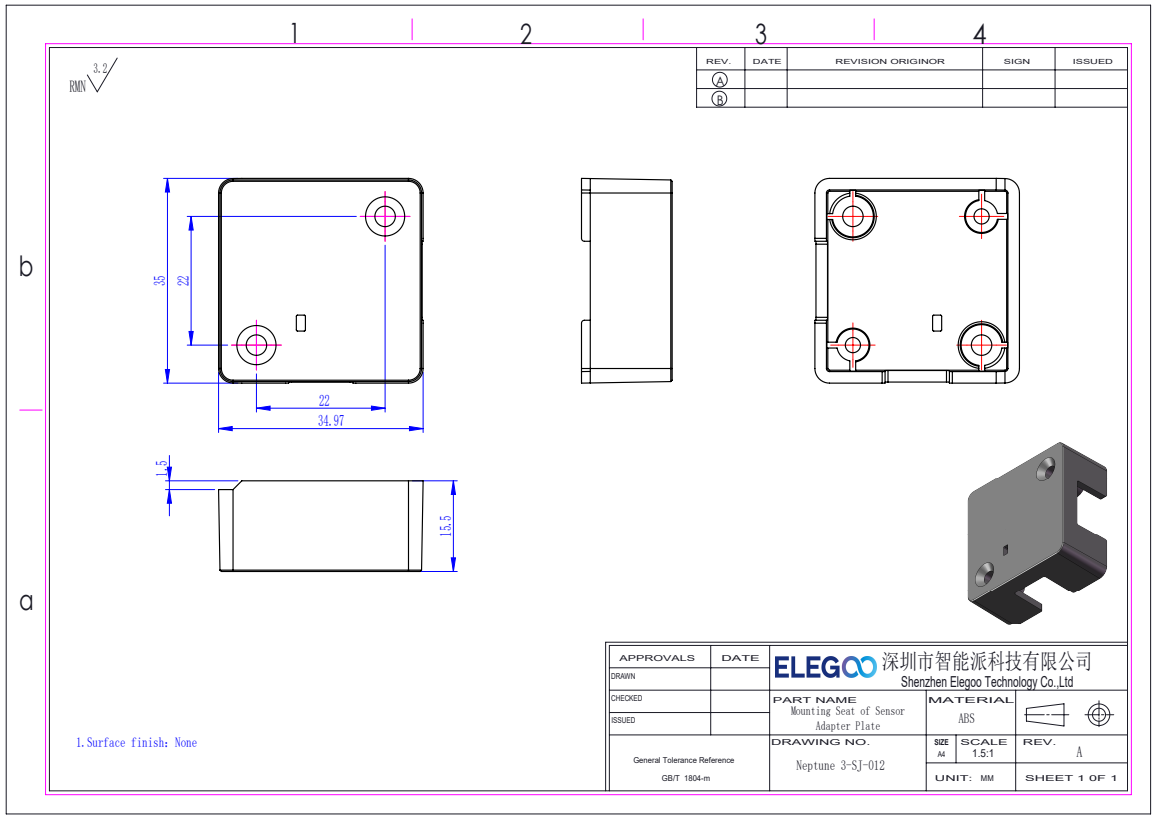
[picture p12: page 1]
Neptune 3-SJ-012; 1.Surface finish：None; SIZE SCALE; UNIT: MM; DRAWING NO.; REV.; DATE; REVISION ORIGINOR; SIGN; ISSUED; SHEET 1 0F 1

深圳市智能派科技有限公司
Shenzhen Elegoo Technology Co.,Ltd

PART NAME
Mounting Seat of Sensor
Adapter Plate

General Tolerance Reference
