elegooofficial/Neptune3/2D/Nozzle.PDF

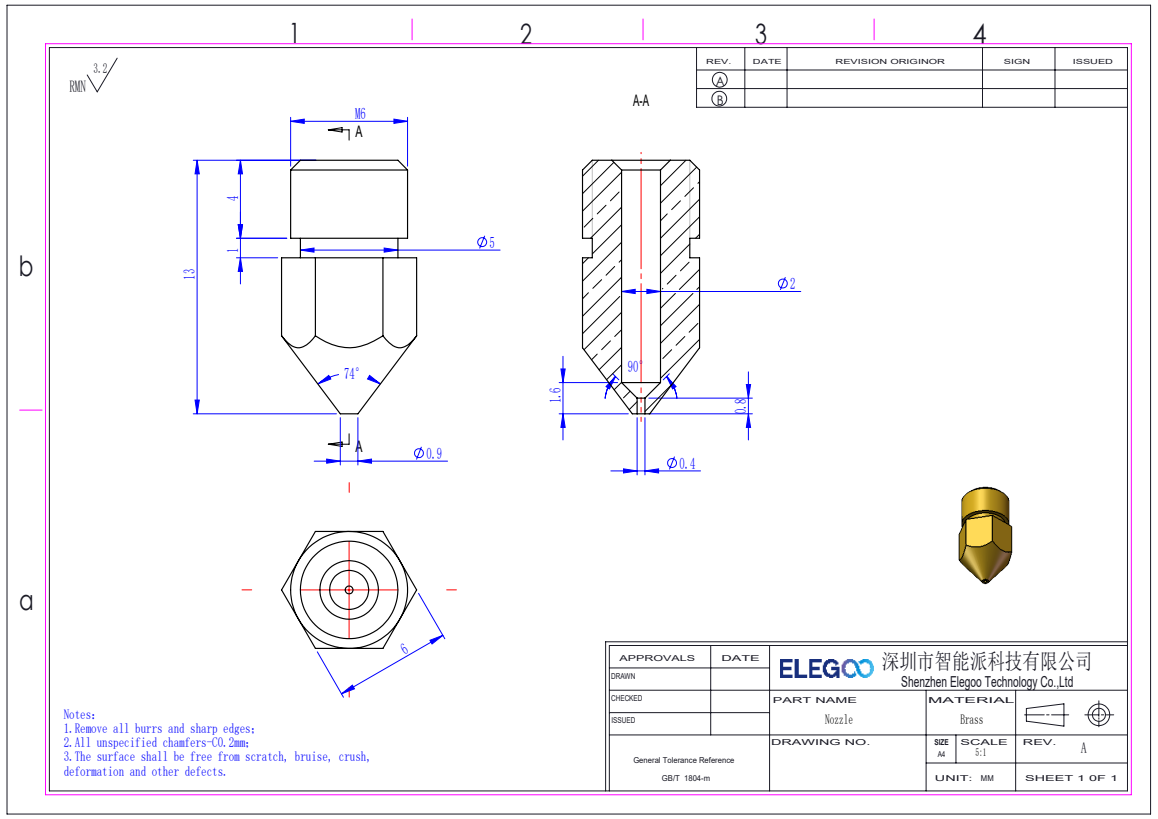
[picture p13: page 1]
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

深圳市智能派科技有限公司
Shenzhen Elegoo Technology Co.,Ltd

Notes：
1.Remove all burrs and sharp edges；
2.All unspecified chamfers-C0.2mm；
3.The surface shall be free from scratch, bruise, crush,
deformation and other defects.

General Tolerance Reference
