elegooofficial/Neptune3/2D/Passive Slider.PDF

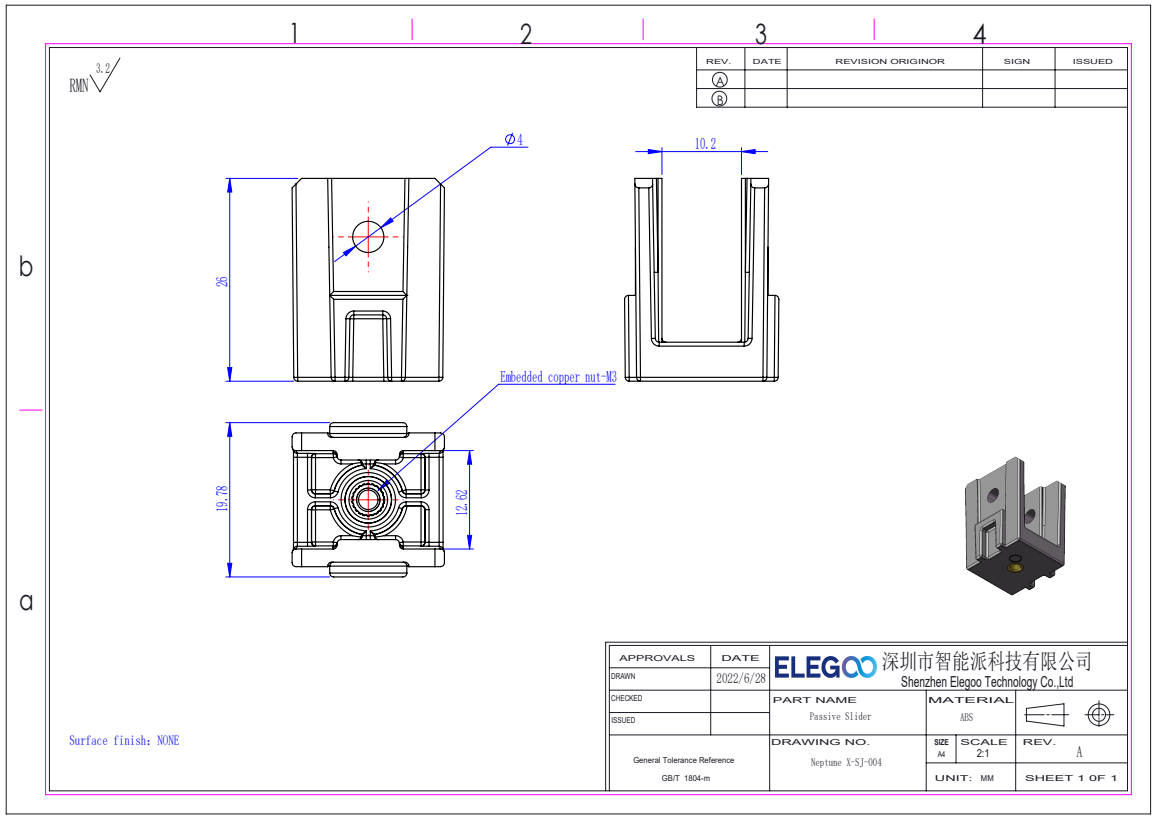
[picture p14: page 1]
Passive Slider; ABS; Neptune X-SJ-004; Surface finish：NONE; SIZE SCALE; UNIT: MM; DRAWING NO.; REV.; DATE; REVISION ORIGINOR; SIGN; ISSUED; PART NAME; SHEET 1 0F 1

Embedded copper nut-M3

深圳市智能派科技有限公司
Shenzhen Elegoo Technology Co.,Ltd

General Tolerance Reference
