elegooofficial/Neptune3/2D/Tensioner Cover.PDF

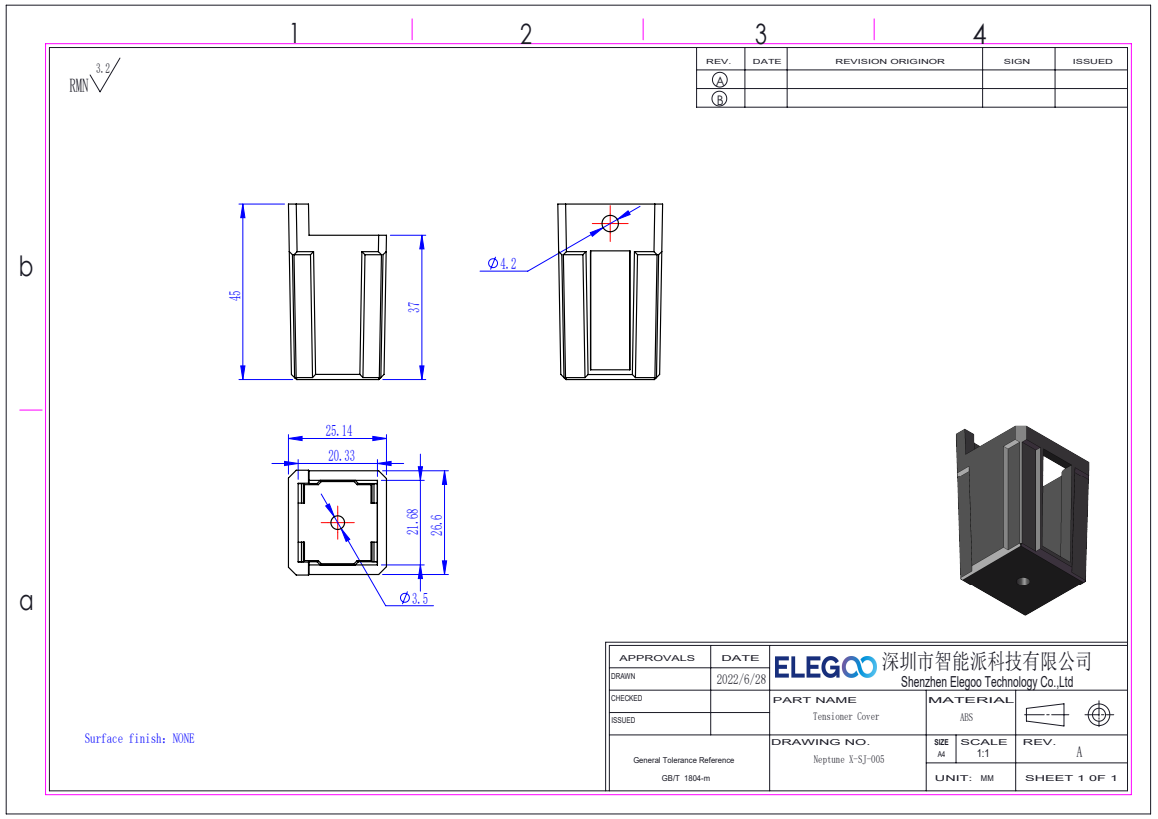
[picture p15: page 1]
Tensioner Cover; ABS; Neptune X-SJ-005; SIZE SCALE; UNIT: MM; DRAWING NO.; REV.; DATE; REVISION ORIGINOR; SIGN; ISSUED; PART NAME; SHEET 1 0F 1

深圳市智能派科技有限公司
Shenzhen Elegoo Technology Co.,Ltd

Surface finish：NONE

General Tolerance Reference
