elegooofficial/Neptune3/2D/Trigger_Photoelectric Switch-A.PDF

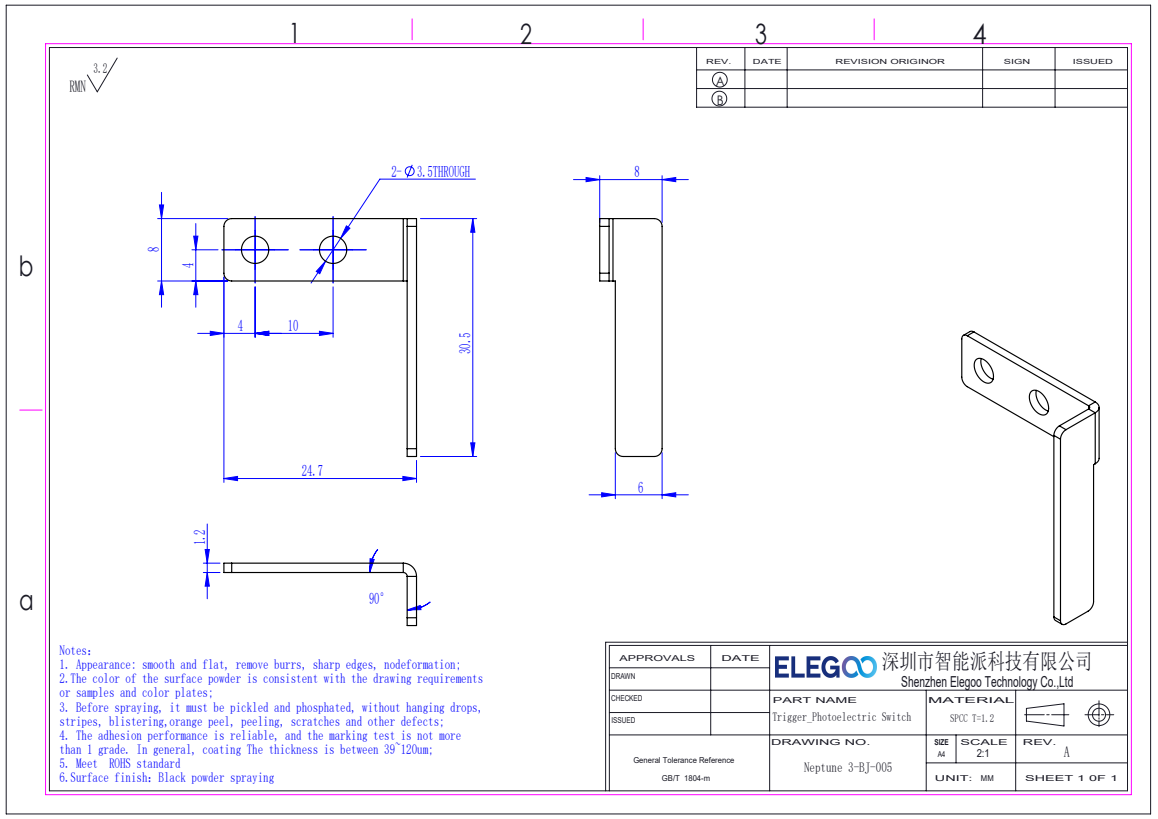
[picture p16: page 1]
2- 3.5THROUGH; Trigger_Photoelectric Switch; SPCC T=1.2; Neptune 3-BJ-005; SIZE SCALE; UNIT: MM; DRAWING NO.; REV.; DATE; REVISION ORIGINOR; SIGN; ISSUED; PART NAME; SHEET 1 0F 1

Notes：
1. Appearance: smooth and flat, remove burrs, sharp edges, nodeformation;
2.The color of the surface powder is consistent with the drawing requirements
or samples and color plates;
3. Before spraying, it must be pickled and phosphated, without hanging drops,
stripes, blistering,orange peel, peeling, scratches and other defects;
4. The adhesion performance is reliable, and the marking test is not more
than 1 grade. In general, coating The thickness is between 39~120um;
5. Meet ROHS standard
6.Surface finish：Black powder spraying

深圳市智能派科技有限公司
Shenzhen Elegoo Technology Co.,Ltd

General Tolerance Reference
