elegooofficial/Neptune3/2D/Cover of Filament Detector Switch-A.PDF

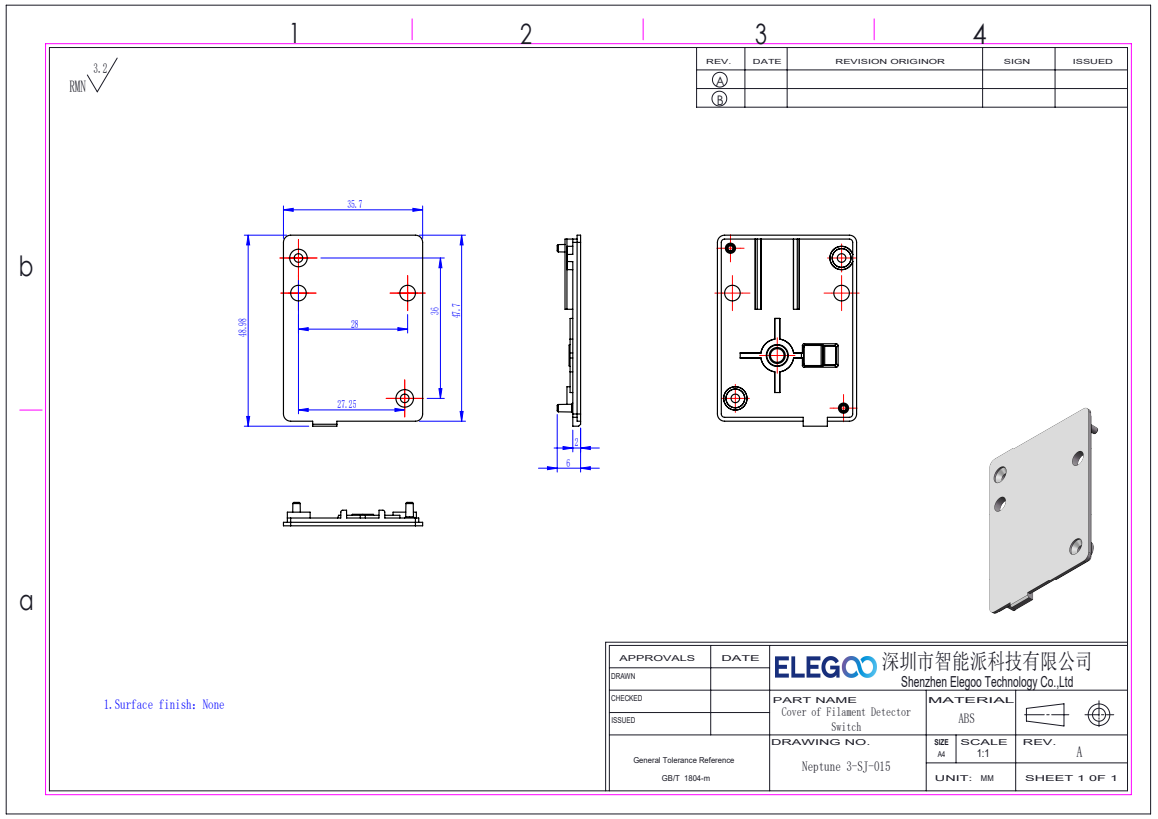
[picture p17: page 1]
Neptune 3-SJ-015; SIZE SCALE; UNIT: MM; DRAWING NO.; REV.; DATE; REVISION ORIGINOR; SIGN; ISSUED; SHEET 1 0F 1

深圳市智能派科技有限公司
Shenzhen Elegoo Technology Co.,Ltd

1.Surface finish：None

PART NAME
ABS Cover of Filament Detector

General Tolerance Reference
