elegooofficial/Neptune3/2D/Display Bracket-A.PDF

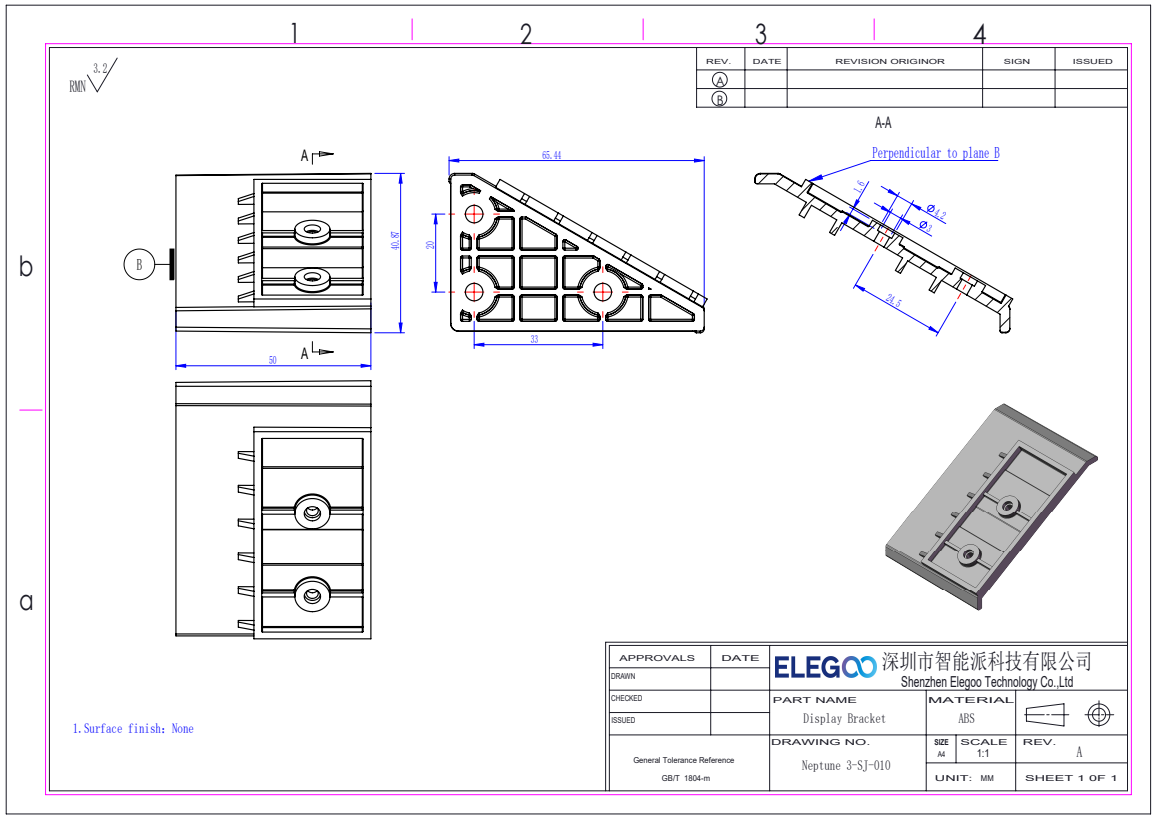
[picture p18: page 1]
Display Bracket; ABS; Neptune 3-SJ-010; SIZE SCALE; UNIT: MM; DRAWING NO.; REV.; DATE; REVISION ORIGINOR; SIGN; ISSUED; PART NAME; SHEET 1 0F 1

Perpendicular to plane B

深圳市智能派科技有限公司
Shenzhen Elegoo Technology Co.,Ltd

1.Surface finish：None

General Tolerance Reference
