elegooofficial/Neptune3/2D/Extruder BaseA.PDF

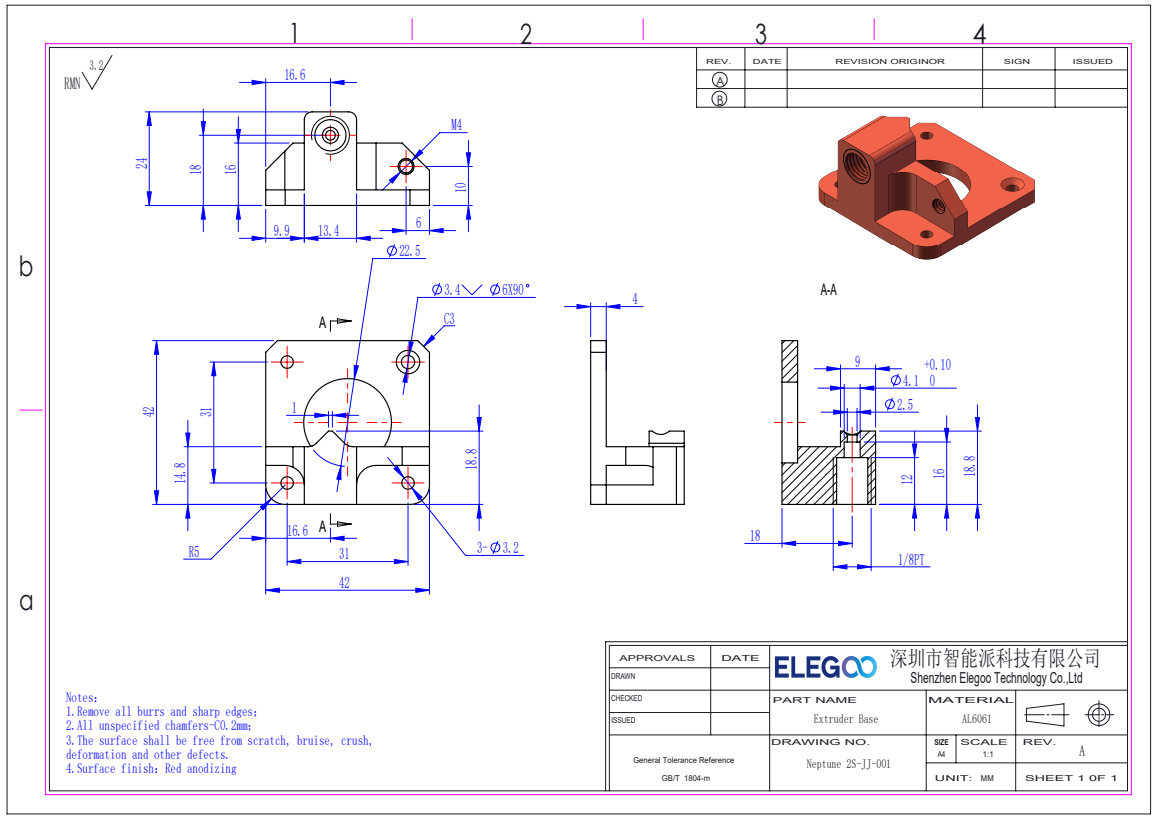
[picture p19: page 1]
Extruder Base; Neptune 2S-JJ-001; SIZE SCALE; UNIT: MM; REV.; DATE; REVISION ORIGINOR; SIGN; ISSUED; PART NAME; SHEET 1 0F 1; DRAWING NO.

深圳市智能派科技有限公司
Shenzhen Elegoo Technology Co.,Ltd

Notes：
1.Remove all burrs and sharp edges；
2.All unspecified chamfers-C0.2mm；
3.The surface shall be free from scratch, bruise, crush,
deformation and other defects.
4.Surface finish：Red anodizing

General Tolerance Reference
