elegooofficial/Neptune3/2D/Fixed Seat of Heated Bed Wire-A.PDF

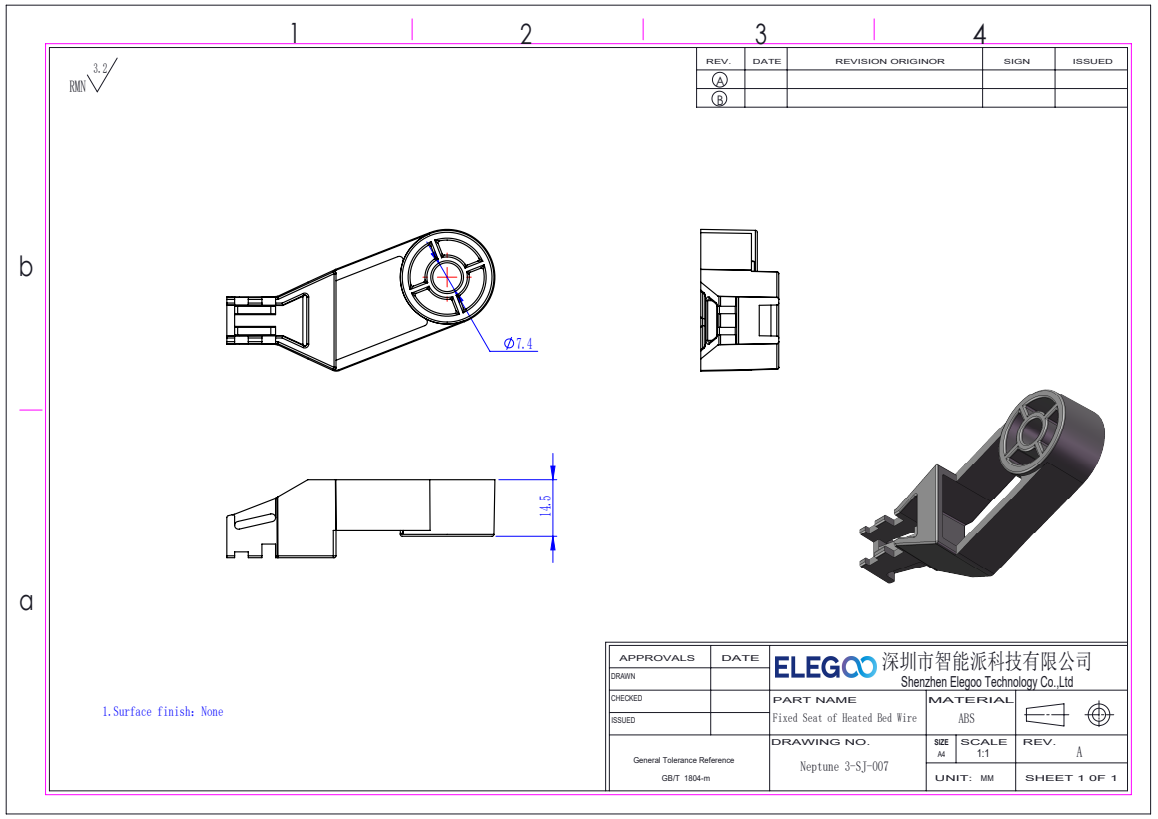
[picture p20: page 1]
Fixed Seat of Heated Bed Wire; ABS; Neptune 3-SJ-007; SIZE SCALE; UNIT: MM; DRAWING NO.; REV.; DATE; REVISION ORIGINOR; SIGN; ISSUED; PART NAME; SHEET 1 0F 1

深圳市智能派科技有限公司
Shenzhen Elegoo Technology Co.,Ltd

1.Surface finish：None

General Tolerance Reference
