elegooofficial/Neptune3/2D/Hand Screw Nut_D20.PDF

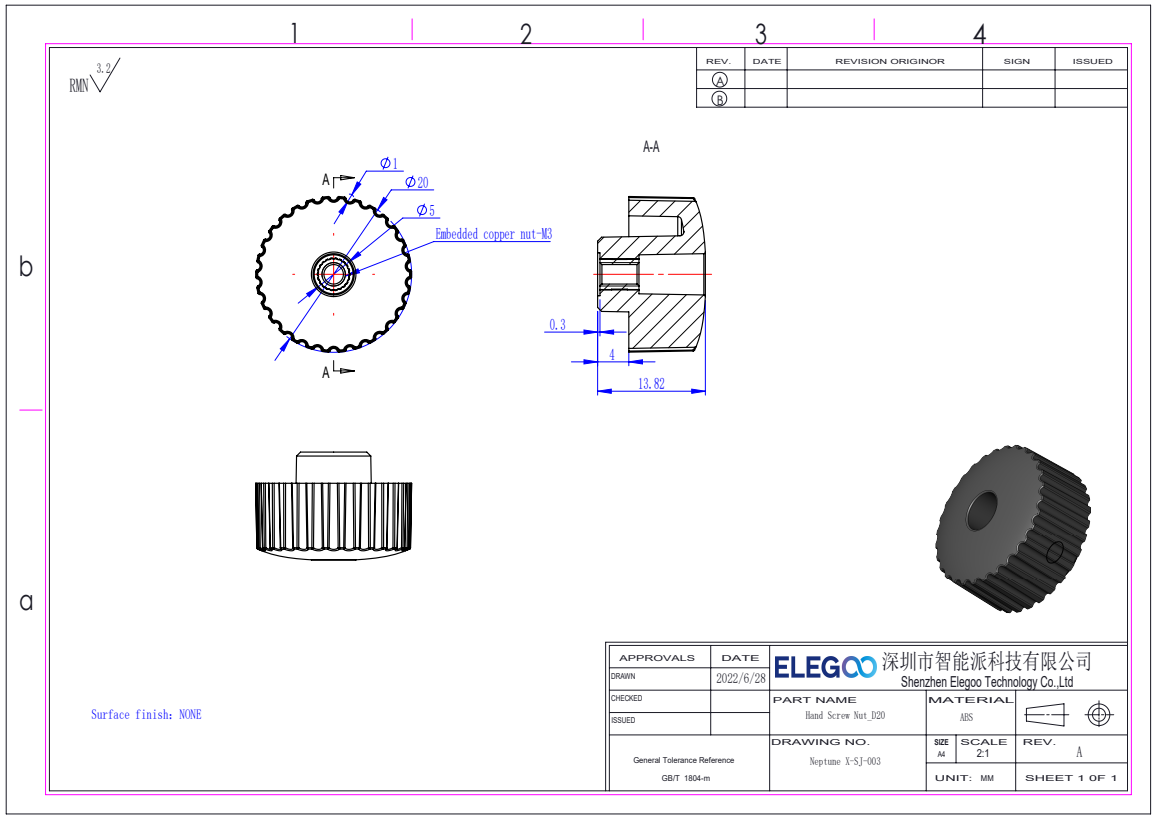
[picture p21: page 1]
Embedded copper nut-M3; Hand Screw Nut_D20; ABS; Neptune X-SJ-003; SIZE SCALE; UNIT: MM; DRAWING NO.; REV.; DATE; REVISION ORIGINOR; SIGN; ISSUED; PART NAME; SHEET 1 0F 1

深圳市智能派科技有限公司
Shenzhen Elegoo Technology Co.,Ltd

Surface finish：NONE

General Tolerance Reference
