elegooofficial/Neptune3/2D/Housing of Display Screen-A.PDF

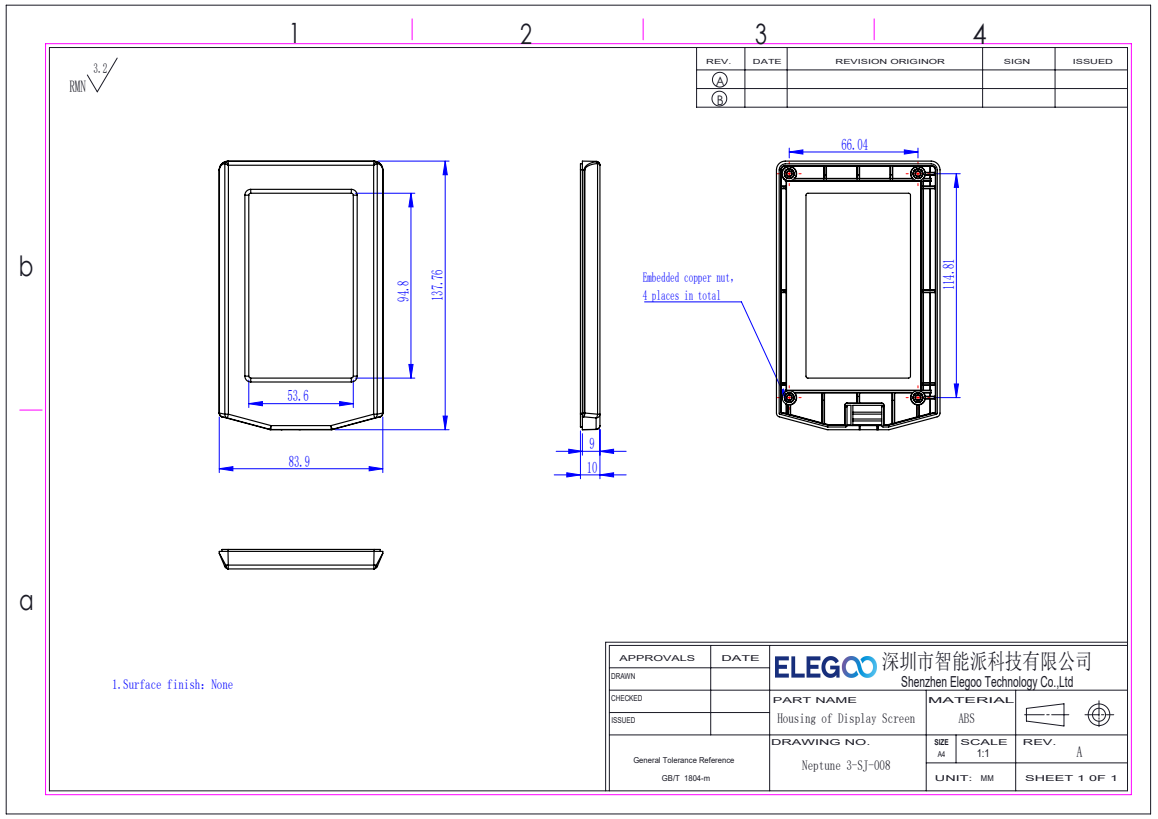
[picture p22: page 1]
Housing of Display Screen; ABS; Neptune 3-SJ-008; SIZE SCALE; UNIT: MM; DRAWING NO.; REV.; DATE; REVISION ORIGINOR; SIGN; ISSUED; PART NAME; SHEET 1 0F 1

Embedded copper nut，
4 places in total

深圳市智能派科技有限公司
Shenzhen Elegoo Technology Co.,Ltd

1.Surface finish：None

General Tolerance Reference
