elegooofficial/Neptune3/2D/Housing of Filament Detector Switch-A.PDF

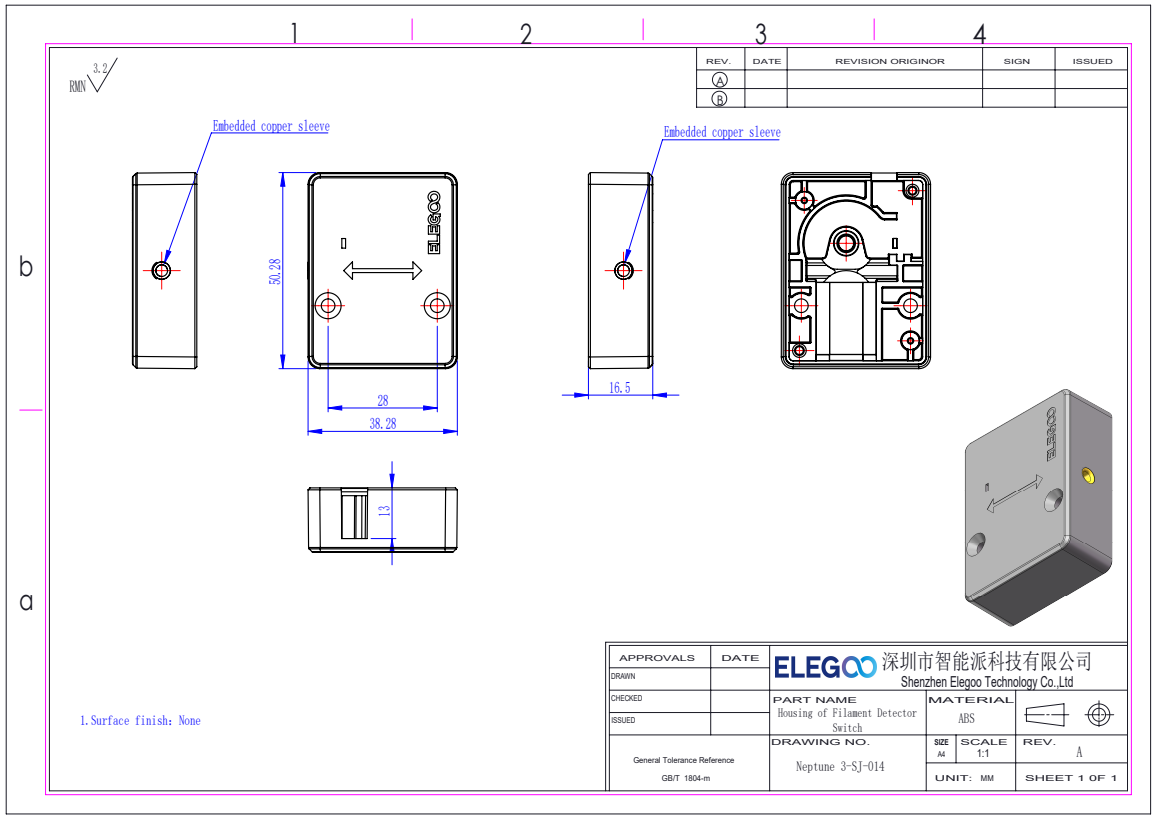
[picture p23: page 1]
Neptune 3-SJ-014; SIZE SCALE; UNIT: MM; DRAWING NO.; REV.; DATE; REVISION ORIGINOR; SIGN; ISSUED; SHEET 1 0F 1

Embedded copper sleeve

深圳市智能派科技有限公司
Shenzhen Elegoo Technology Co.,Ltd

PART NAME
ABS Housing of Filament Detector

1.Surface finish：None

General Tolerance Reference
