elegooofficial/Neptune3/2D/Housing of Photoelectric Switch-A.PDF

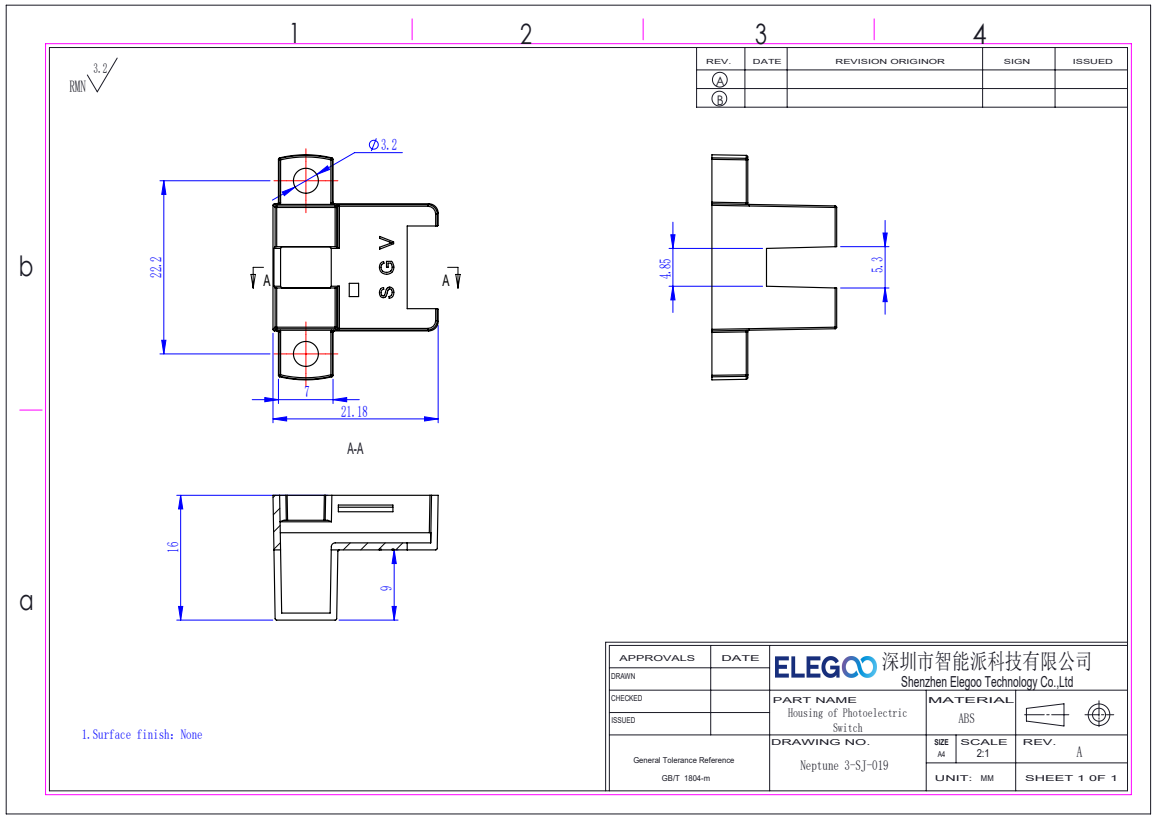
[picture p24: page 1]
Neptune 3-SJ-019; SIZE SCALE; UNIT: MM; DRAWING NO.; REV.; DATE; REVISION ORIGINOR; SIGN; ISSUED; SHEET 1 0F 1

深圳市智能派科技有限公司
Shenzhen Elegoo Technology Co.,Ltd

PART NAME
ABS Housing of Photoelectric

Switch 1.Surface finish：None

General Tolerance Reference
