elegooofficial/Neptune3/Wire/Black Silicone Wire.pdf

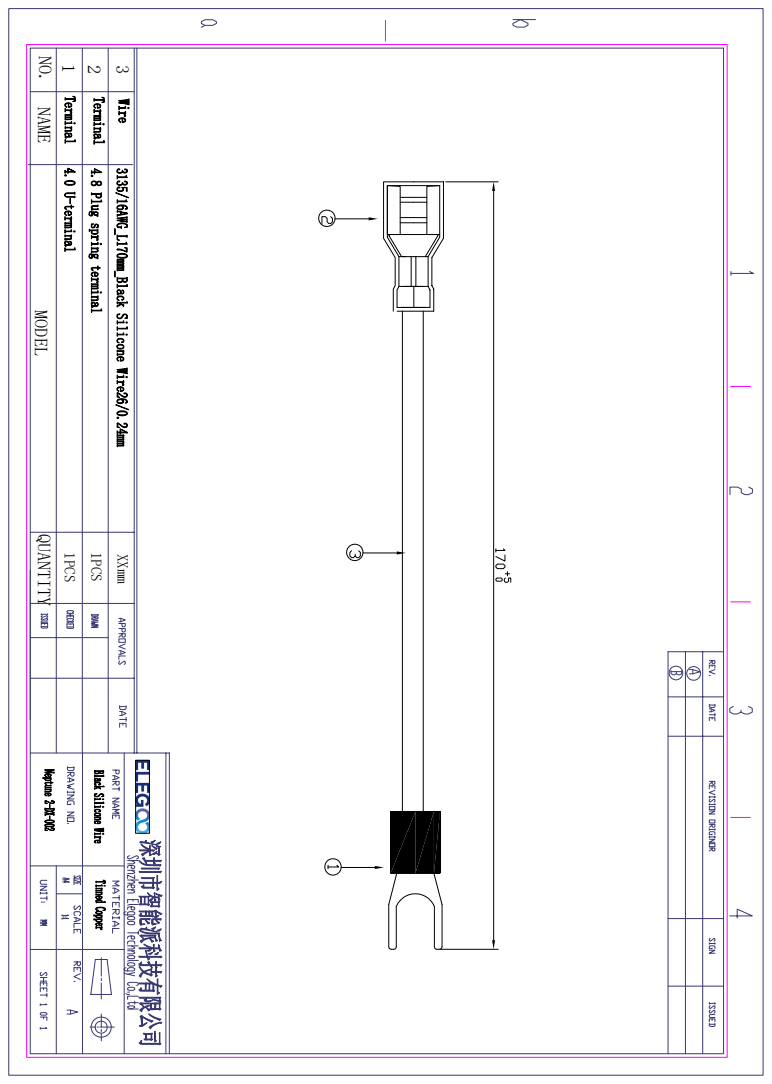
[picture p25: page 1]
NAME MODEL; 1PCS; XXmm; QUANTITY
