elegooofficial/Neptune3/Wire/Filament Detector Wire.pdf

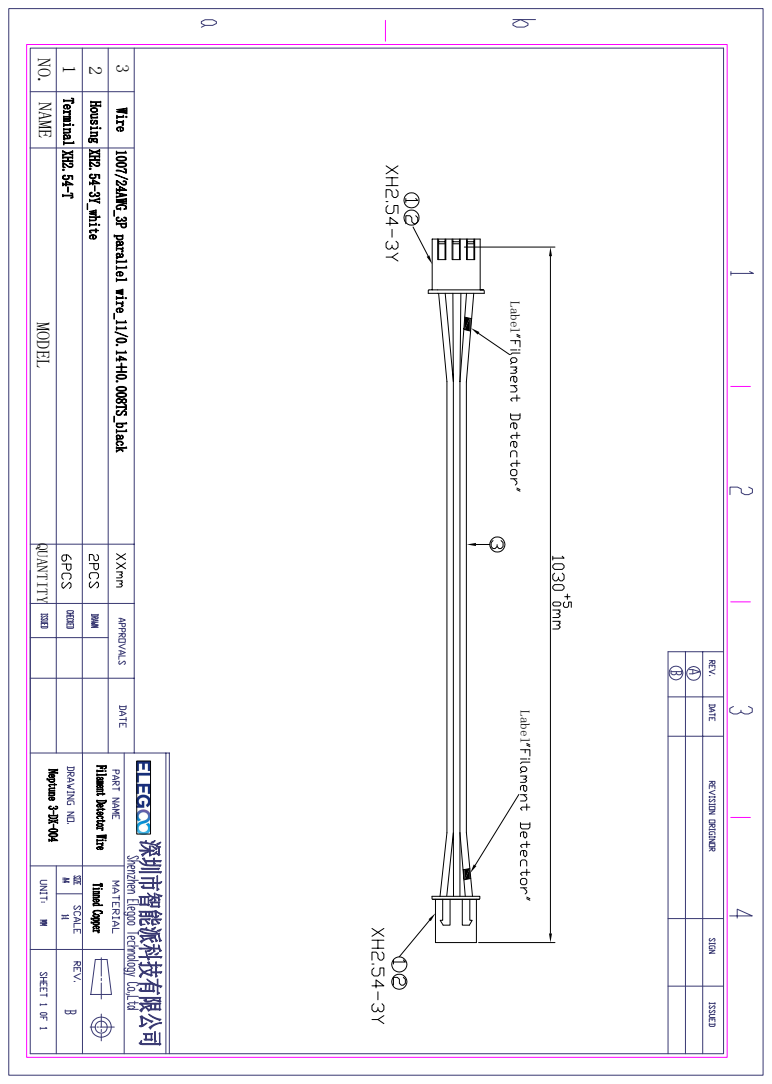
[picture p26: page 1]
Label

QUANTITY NO. NAME MODEL
