elegooofficial/Neptune3/Wire/Motor and Limit Switch Wire_XE-axis.pdf

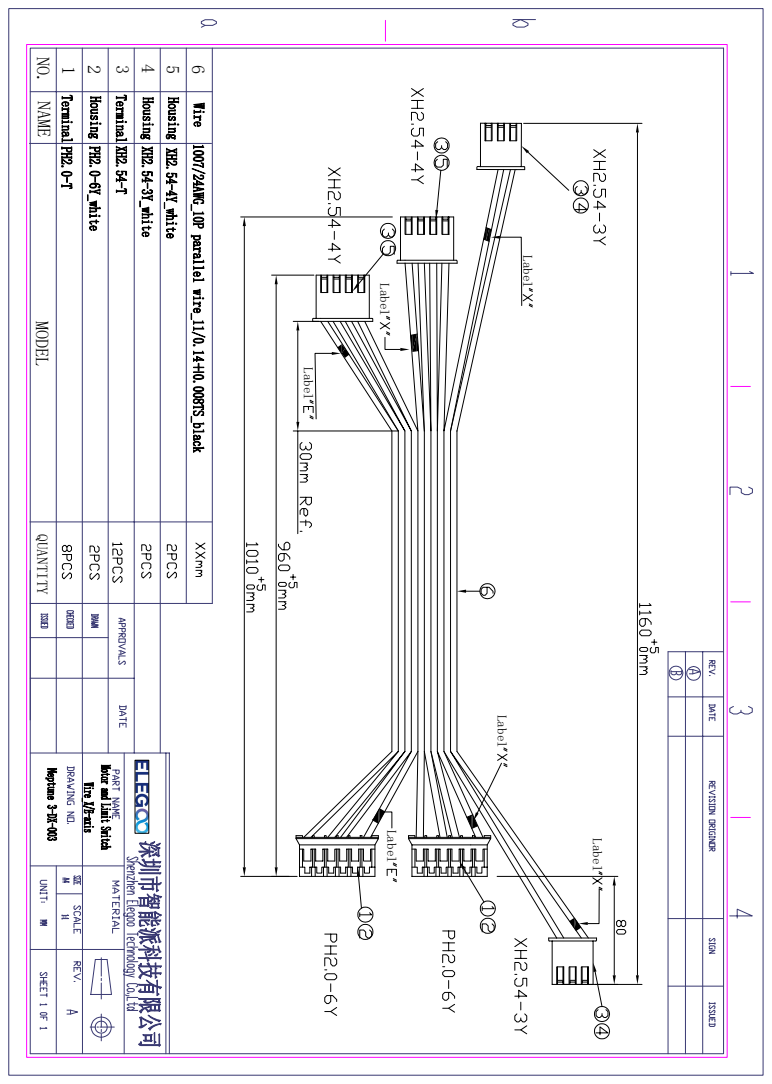
[picture p27: page 1]
Label

QUANTITY NO. NAME MODEL
