elegooofficial/Neptune3/Wire/Motor and Limit Switch Wire_Y-axis.pdf

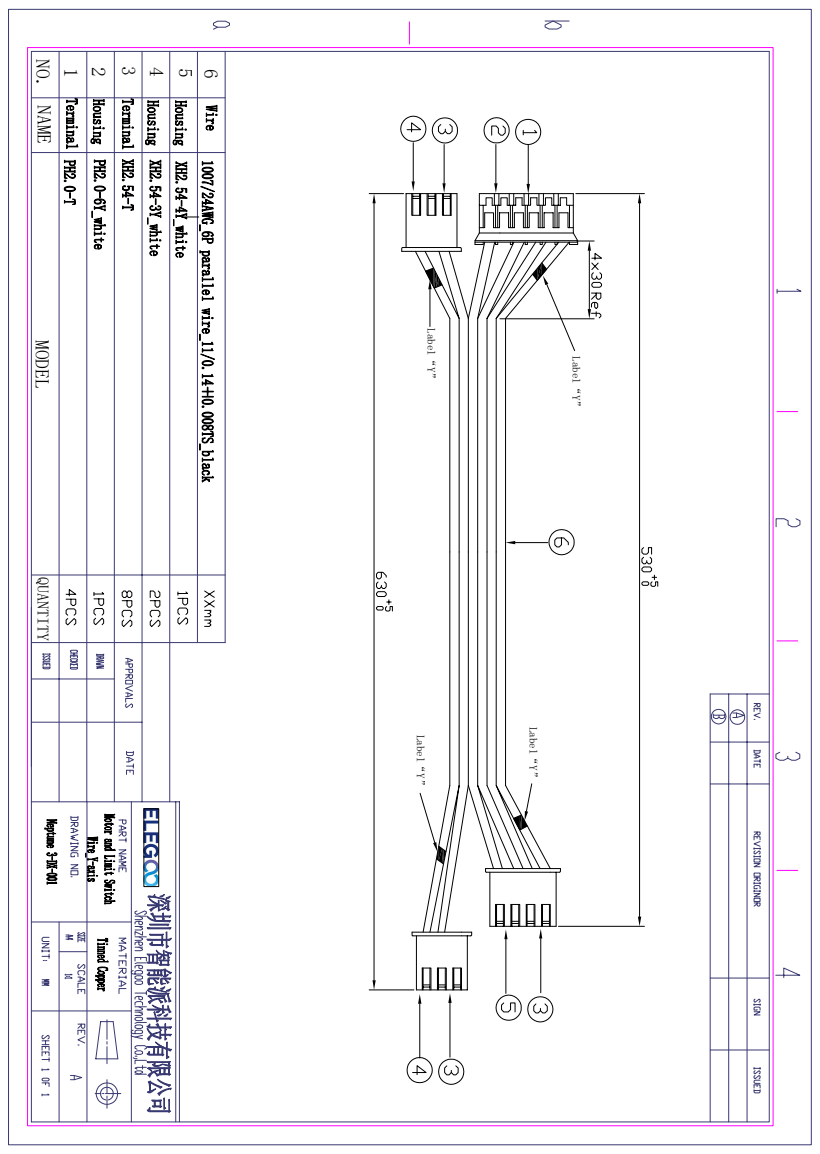
[picture p28: page 1]
Label“Y”

NO. NAME MODEL QUANTITY
