elegooofficial/Neptune3/Wire/Motor Wire_Z-axis.pdf

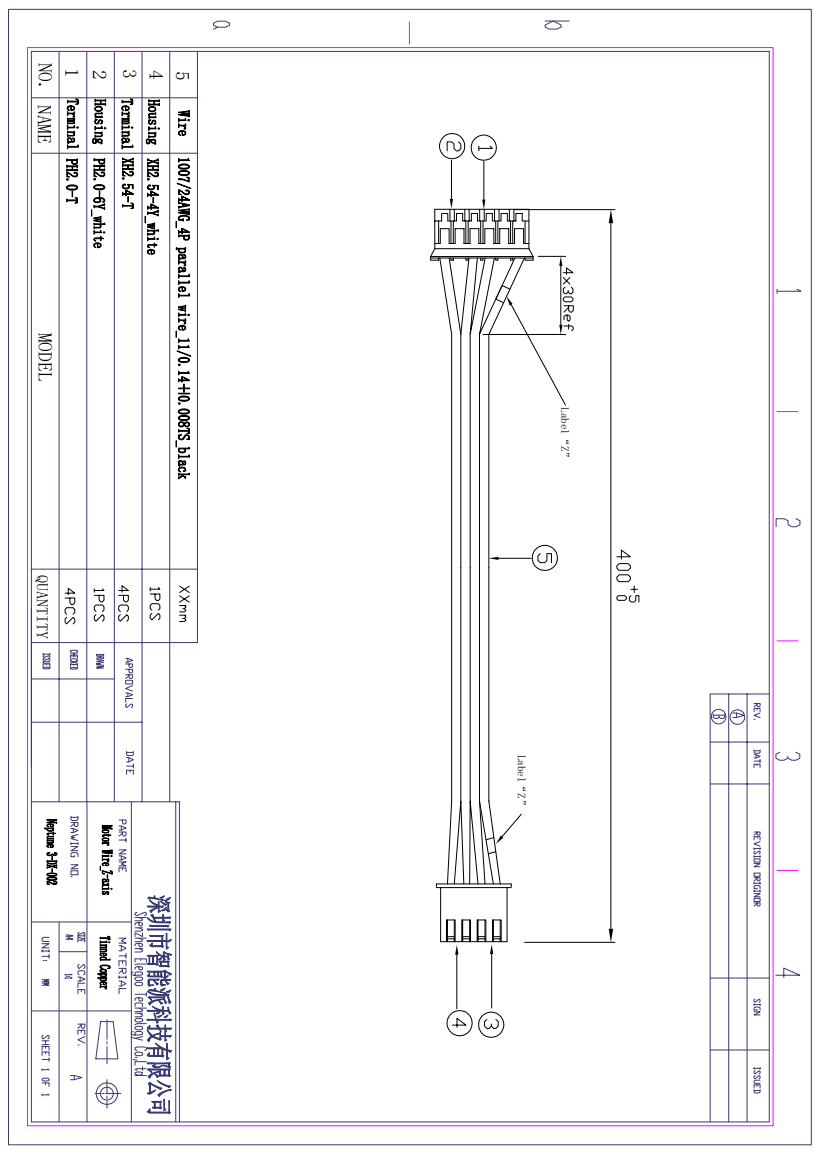
[picture p29: page 1]
Label“Z”

NO. NAME MODEL QUANTITY
