elegooofficial/Neptune3/Wire/Photoelectric Switch Wire.pdf

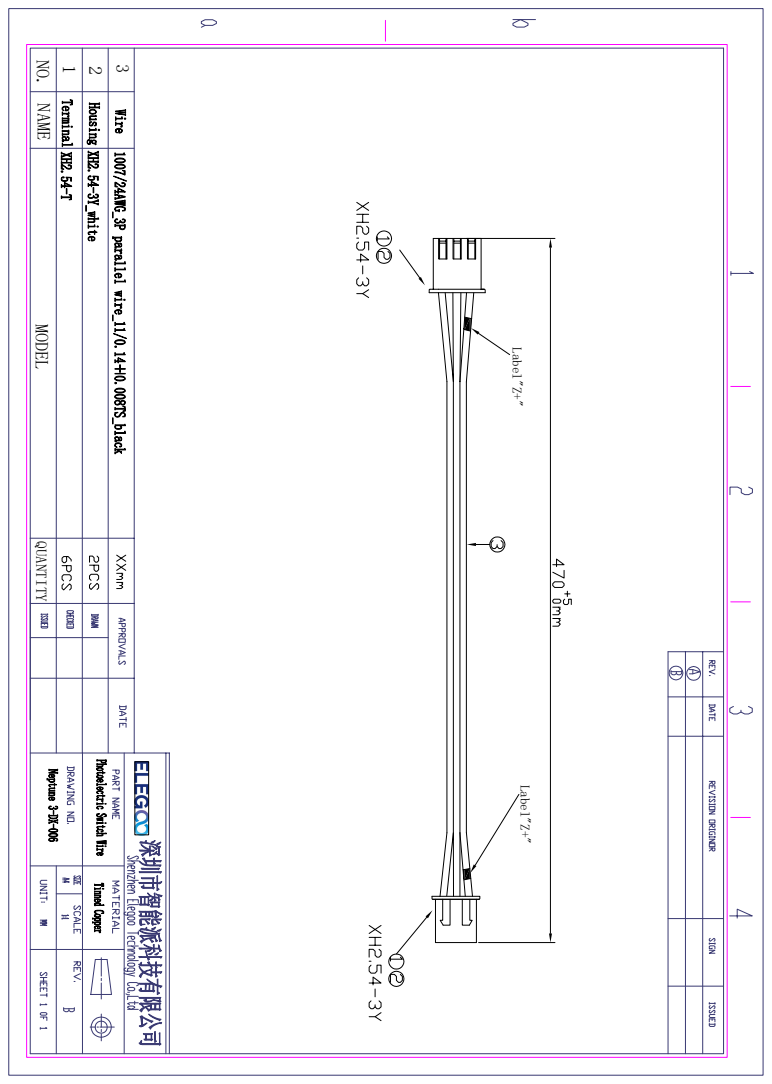
[picture p30: page 1]
Label"Z+" Label"Z+"

QUANTITY NO. NAME MODEL
