elegooofficial/Neptune3/Wire/Pressure Sensor Wire.pdf

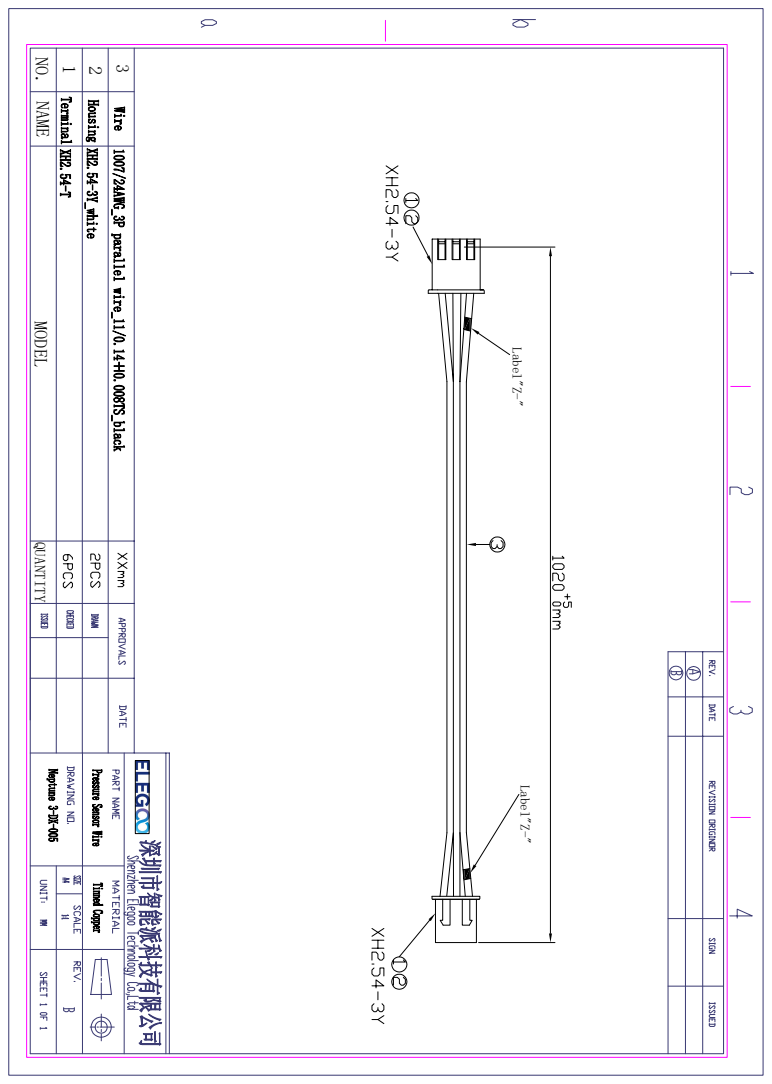
[picture p31: page 1]
Label"Z-" Label"Z-"

QUANTITY NO. NAME MODEL
