elegooofficial/Neptune3/Wire/Red And Black Wire_Mainboard.pdf

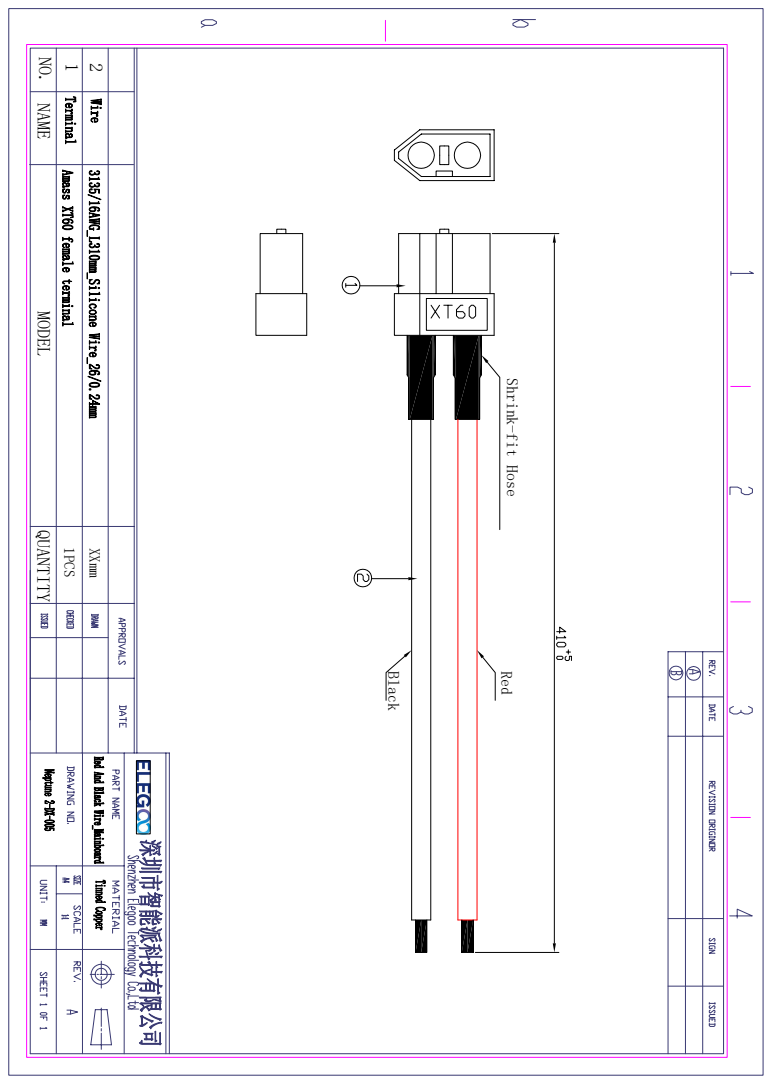
[picture p32: page 1]
NAME MODEL; 1PCS; XXmm; QUANTITY; Black; Red

Shrink-fit Hose
