elegooofficial/Neptune3/Wire/Red And Black Wire_Power Supply.pdf

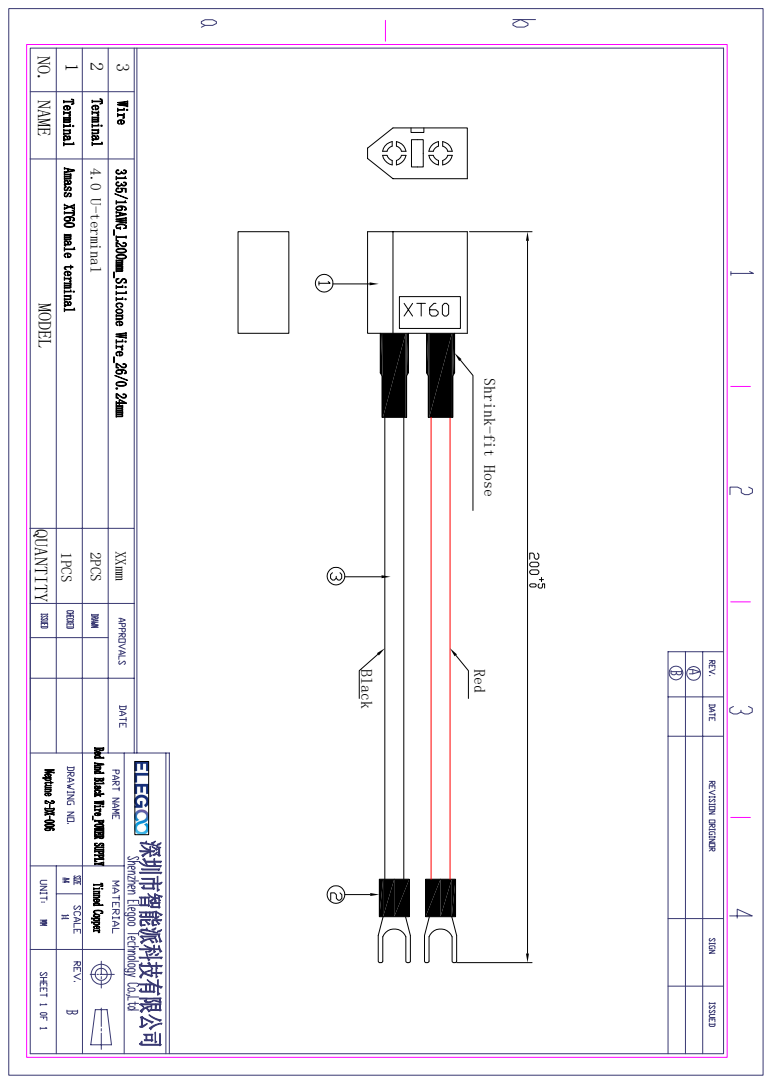
[picture p33: page 1]
Black; Red; 4.0 U-terminal; 1PCS; XXmm; QUANTITY; 2PCS

NO. NAME MODEL

Shrink-fit Hose
