elegooofficial/Neptune3/Wire/Red Silicone Wire.pdf

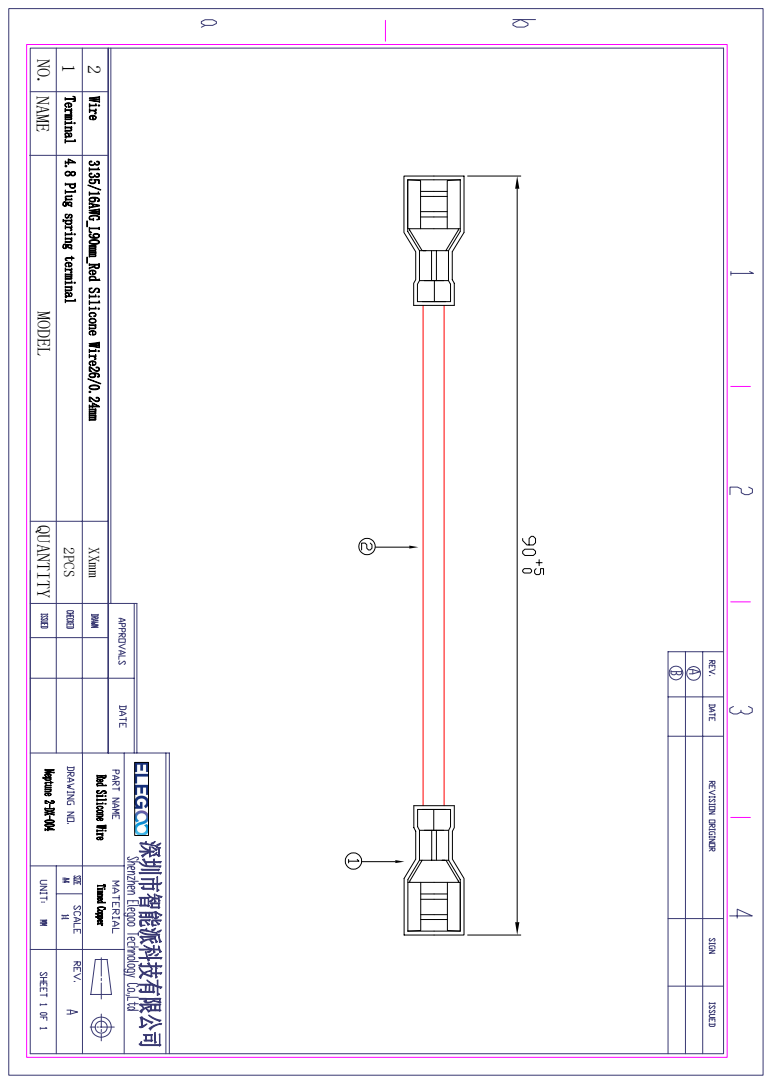
[picture p34: page 1]
NAME MODEL; 2PCS; XXmm; QUANTITY
