elegooofficial/Neptune3/Wire/Red Silicone Wire_Combined Switch.pdf

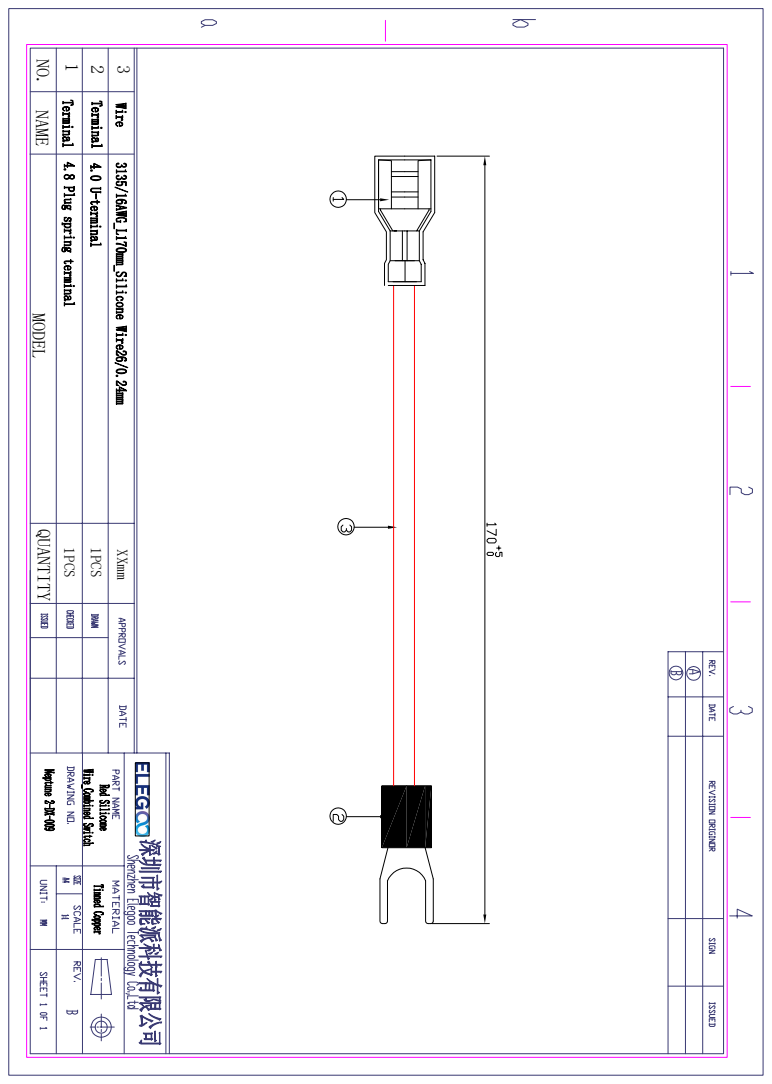
[picture p35: page 1]
1PCS; XXmm; QUANTITY

NO. NAME MODEL
