elegooofficial/Neptune3/2D/2020 Aluminum profile_Top.PDF

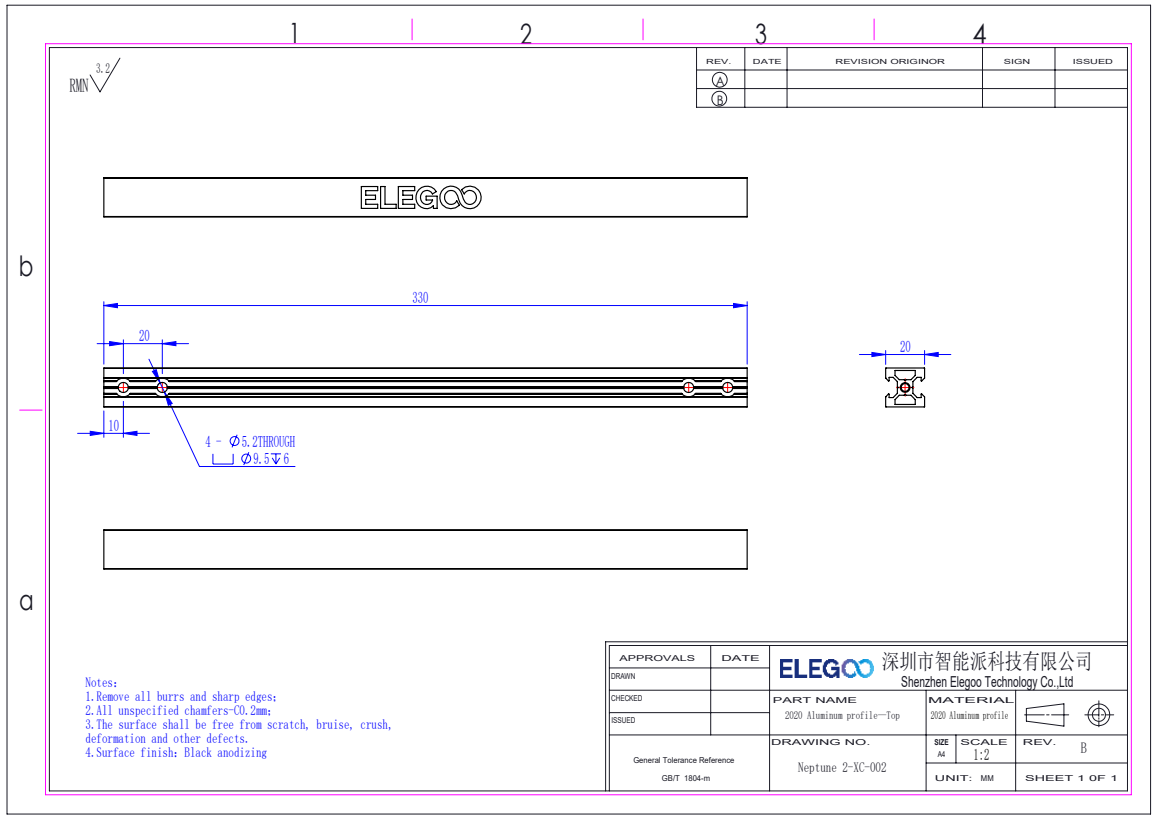
[picture p36: page 1]
5.2THROUGH; 2020 Aluminum profile; Neptune 2-XC-002; 4.Surface finish：Black anodizing; SIZE SCALE; UNIT: MM; DRAWING NO.; REV.; DATE; REVISION ORIGINOR; SIGN; ISSUED; SHEET 1 0F 1

深圳市智能派科技有限公司
Shenzhen Elegoo Technology Co.,Ltd

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

PART NAME
2020 Aluminum profile—Top

General Tolerance Reference
